Hemlock-white/Babot_revisioned_Mechatronics_TermProject/docs/develope_log.md

# BaBot development log

This log records the development sequence supported by the available files and conversation. Exact dates for the early conversion steps were not recorded. The new Git commits reconstruct milestones from KiCad's saved snapshots and the present files; their timestamps are **repository import dates**, not original design dates.

## Original project and local source archive

- **2025 source downloads:** Johan Link's [BABOT repository](https://github.com/JohanLink/BABOT) supplied `main.ino`, its README, and its CC BY-NC 4.0 license. Original Base and Plate PCBWay Gerbers/BOMs, the combined mechanical STL, a schematic PDF, and saved reference pages were downloaded separately. They are preserved in [`original/`](../original/) without editing their content. The PCBWay download names indicate 2025-05-26 for the Plate and 2025-05-27 for the Base; these are file labels, not verified manufacturing dates.
- **Early THT reconstruction; date not recorded:** Editable KiCad Base and Plate layouts were reconstructed from the original manufacturing Gerbers, flying-probe data, BOMs, and schematic information. The first Base version used an Arduino Micro module, through-hole parts, and the older digital-pot arrangement. The earliest surviving KiCad local-history snapshot is represented by the repository's initial THT commit; the superseded Base files remain in [`history/PCB/initial_THT_Base/`](../history/PCB/initial_THT_Base/).
- **Module and component revision; date not recorded:** The Base multiplexer IC was changed to a CD74HC4067 breakout module. A saved intermediate Base revision is captured as its own Git commit. The digital-pot module was then replaced by a Bourns 3296W 100 kΩ, 25-turn trimmer. The Plate design uses through-hole IR parts, a 2×10 header, and an FQP30N06L switch with a 220 Ω gate resistor. These circuit choices still need physical validation.
- **Routing attempts; date not recorded:** A two-layer Base layout was attempted, but its last recorded DRC had six signal and one GND connection open. The draft and trial files are archived in [`history/PCB/`](../history/PCB/). A separate four-layer Base was completed and routed; its last KiCad DRC reported zero violations and zero unconnected items.
- **2026-10-10 — Base fabrication and purchase data:** Four-layer Base Gerbers and drill files were exported and packaged as [`PCB/fabrication/BaBot_Base_THT_4layer_Gerbers.zip`](../PCB/fabrication/BaBot_Base_THT_4layer_Gerbers.zip). Both BOMs were grouped by purchasable part and given one-board/five-board quantities, stock fields, checkboxes, and supplier links. The Base power path uses a provisional 2 A assumption and an ordering recommendation of 1 oz inner copper; the actual servo loading has not been measured.
- **2026-10-11 — Repository organization:** Original downloads were separated from working files, early KiCad milestones were committed in sequence, and superseded Base work was moved to `history/`. `software/main.ino` is currently unchanged from the available upstream copy; there is no separately modified firmware yet. Hardware and system behavior have not been bench-tested.

## Routed Plate import and fabrication review

- **2026-10-13 — Gerbers supplied:** The owner placed the newer two-layer `BaBot_Plate_v2THT` package at [`PCB/fabrication/plate_THT_2layers_Gerbers.zip`](../PCB/fabrication/plate_THT_2layers_Gerbers.zip), with unpacked files in [`PCB/fabrication/plate/`](../PCB/fabrication/plate/). This is distinct from the original SMD Plate archive.
- **2026-10-13 — Export issue identified:** JLCPCB reported missing top and bottom solder masks. Both named mask files have no pad-opening graphics, and the package has no drill files. The Gerber job lists two copper layers, 1.6 mm thickness, and a 100.0456 × 101.5921 mm board. See the [detailed review and correction steps](../PCB/fabrication/plate/REVIEW_NOTES.md). The ZIP is **not fabrication-ready**.
- **Editable source still pending:** The routed `BaBot_Plate_v2THT.kicad_pcb` and project folder have not been located in this workspace. The Plate KiCad file currently under `PCB/KiCad/` is the older unrouted copy. A corrected Gerber/drill package, DRC, Base–Plate cable check, mechanical fit check, and prototype optical/electrical tests remain pending.
- **2026-10-13 — Circuit teaching:** Separate original and current THT circuit guides were written, then turned into offline HTML lessons with electrical schematics, power maps, a two-scan timing graph, and interactive sensor/mux/load examples. Software teaching remains deferred.
- **2026-10-13 — Software teaching:** A root-level, offline [BaBot navigator](../BaBot_導覽.html) was built from the unchanged `software/main.ino`. It embeds all 565 source lines, maps five verified architecture paths to code, and offers five theory modules with locally graded exercises. The builders and reviewed lesson data remain in `docs/`.

## Teaching documents

[`hardware_explained.md`](hardware_explained.md) remains intentionally blank. The electronics/circuit teaching has separate illustrated HTML lessons for the [original design](electronics_original.html) and [current THT/module design](electronics_tht.html), generated from their Markdown guides by [`build_electronics_html.py`](build_electronics_html.py). Software teaching is the root-level [architecture navigator](../BaBot_導覽.html), generated by [`build_software_navigator.py`](build_software_navigator.py) from a reviewed map of the upstream sketch. Previous Base/Plate circuit-learning drafts remain in [`history/notes/`](../history/notes/).
