Hemlock-white/Babot_revisioned_Mechatronics_TermProject/hardware/set up pics/Screenshot 2026-10-27 174410.png

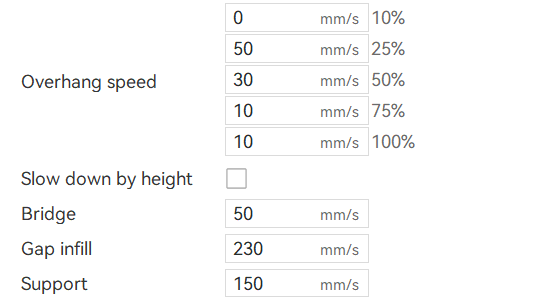
hardware/set up pics/Screenshot 2026-10-27 174410.png
