Hemlock-white/Babot_revisioned_Mechatronics_TermProject/PCB/KiCad/BaBot_Base_THT_4067_Module_BOM.csv

Have full 5-board qty? | References | Component / value | Qty per board | Qty for 5 boards | Qty on hand | Footprint / use | Side | Purpose / notes | Supplier Link
 | U4 | Arduino Micro A000053 | 1 | 5 |  | Arduino_Micro_A000053 | F | Preassembled ATmega32U4 module; USB logic supply and programming | https://shopee.tw/search?keyword=Arduino%20Micro%20A000053%20ATmega32U4%20original%20module
 | RV1 | Bourns 3296W-1-104LF 100k 25-turn | 1 | 5 |  | Potentiometer_THT:Potentiometer_Bourns_3296W_Vertical | F | Adjustable sensor-load resistor; pad 1 POT_H, wiper 2 and end 3 GND. Set about 10 kΩ from pad 1 to ground before power-up. | https://www.lcsc.com/product-detail/C48084.html
V | U1 | CD74HC4067 16-channel module | 1 | 5 |  | BaBot_THT:CD74HC4067_Module | F | THT breakout module containing CD74HC4067; connector positions mapped to standard IC pin numbers for schematic consistency | https://shopee.tw/search?keyword=CD74HC4067%2016%20channel%20multiplexer%20module
2 1*10 | U3 | 20-way header to Plate | 1 | 5 |  | Header20 | F | 2x10 2.54 mm male header to Plate; mate pin 1 to pin 1. | https://www.lcsc.com/product-detail/C54803349.html
V | H1,H2,H3 | Servo signal/+5V/GND | 3 | 15 |  | Position-specific THT footprints; see PCB refs | B | Three 3-pin servo headers; +5V_MOTORS, GND, signal. | https://s.taobao.com/search?q=PZ254V-11-03P%202.54mm%201x3%20vertical%20male%20pin%20header
 | R1,R7 | 10k | 2 | 10 |  | Axial_R_10.16 | B | 10 kΩ 0.25 W axial resistors; 10.16 mm lead spacing. | https://www.lcsc.com/product-detail/C2903232.html
 | R10,R18 | 500 | 2 | 10 |  | Axial_R_10.16 | B | 500 Ω 0.25 W axial resistors; R18 is in sensor-trimmer path. | https://www.lcsc.com/product-detail/C1370878.html
[] | C1 | 220nF leaded ceramic | 1 | 5 |  | Ceramic_5mm | B | 220 nF radial ceramic capacitor; 5 mm lead spacing. | https://shopee.tw/search?keyword=220nF%200.22uF%20ceramic%20disc%20capacitor%20radial%205mm%20pitch
 | C5 | 10uF 16V | 1 | 5 |  | Electrolytic_5mm | F | 10 µF 16 V leaded electrolytic on servo rail; check polarity and 2 mm lead pitch. | https://www.lcsc.com/product-detail/C442560.html
 | SW1 | Momentary NO | 1 | 5 |  | Pushbutton_6mm | F | Original active-high mode button; standard THT switch | https://shopee.tw/search
 | U15 | Red LED 3mm | 1 | 5 |  | LED_3mm | F | Original LED function; KiCad pin 1 cathode, pin 2 anode | https://shopee.tw/search?keyword=3mm%20red%20LED%20through%20hole%202%20lead
 | J1 | 5V servo power input | 1 | 5 |  | Power_Terminal | F | External regulated 5 V servo supply; separate from Micro USB logic supply | https://www.lcsc.com/product-detail/C5183929.html
V | ASSEMBLY-SOCKETS | 2.54 mm 1x40 female socket strip; 8.5 mm insulation height | 2 | 10 |  | Off-board stock cut into socket strips | F | Two 40-position strips supply 2x17 sockets for Arduino Micro plus 1x16 and 1x8 for mux module; verify module underside clearance and cutting waste. | https://www.lcsc.com/product-detail/C2977610.html
V | ASSEMBLY-PINS | 2.54 mm 1x40 male breakaway header | 2 | 10 |  | Off-board stock for module pins | F | Conditional: two strips supply 2x17 Arduino pins plus 1x16 and 1x8 mux pins if module headers are not pre-soldered; buy zero if both modules already have pins. | https://www.lcsc.com/product-detail/C2337.html
 | BASE-PLATE-CABLE | 20-conductor 2x10 double-ended IDC ribbon cable, 200 mm | 1 | 5 |  | Off-board interconnect | — | One straight-through cable per assembled Base+Plate pair. Verify female ends, 2.54 mm pitch, pin-1 orientation and suitable length. Counted only in Base BOM. | https://www.lcsc.com/product-detail/C7465815.html
