Hemlock-white/Babot_revisioned_Mechatronics_TermProject/PCB/KiCad/BaBot_Plate_THT_BOM.csv

Have full 5-board qty? | References | Component / value | Qty per board | Qty for 5 boards | Qty on hand | Footprint / use | Side | Purpose / notes | Supplier Link
 | IR1-IR21 | IR204/H60 | 21 | 105 |  | Position-specific THT footprints; see PCB refs | F | 21 infrared emitters; check anode/cathode orientation and optical match. | https://www.lcsc.com/product-detail/C60099.html
[] | Q1-Q16 | 1540031NC6090 | 16 | 80 |  | Position-specific THT footprints; see PCB refs | F | 16 infrared phototransistors; check polarity and package fit. | https://shopee.tw/search?keyword=Wurth%20Elektronik%201540031NC6090%20940nm%20phototransistor
 | R1-R21 | 330 | 21 | 105 |  | Axial_R_10.16 | B | 330 Ω 0.25 W axial IR current-limiting resistors; 10.16 mm lead spacing. | https://www.lcsc.com/product-detail/C2894590.html
 | U1 | 20-way header to Base | 1 | 5 |  | Header20 | B | 2x10 2.54 mm male header to Base, mounted on underside; pin 1 to pin 1. | https://www.lcsc.com/product-detail/C54803349.html
[] | Q17 | FQP30N06L | 1 | 5 |  | TO220_GDS | B | Logic-level THT MOSFET; G-D-S remapped from original G-S-D | https://www.lcsc.com/product-detail/C243087.html
 | R22 | 10k | 1 | 5 |  | Axial_R_10.16 | B | Gate pulldown, retained downstream of added gate resistor | https://www.lcsc.com/product-detail/C2903232.html
 | R23 | 220 | 1 | 5 |  | Axial_R_10.16 | B | Added MCU gate-current limiting resistor | https://www.lcsc.com/product-detail/C3537012.html
