Hemlock-white/Babot_revisioned_Mechatronics_TermProject/original/pcbway/plate/BOM_Plate_Plate_pcb_2025-05-26_PCBWay Community.csv

No. | Quantity | Comment | Designator | Footprint | Value | Manufacturer Part | Manufacturer | Supplier Part | Supplier
1 | 21 | IR204/H60 | IR1,IR2,IR3,IR4,IR5,IR6,IR7,IR8,IR9,IR10,IR11,IR12,IR13,IR14,IR15,IR16,IR17,IR18,IR19,IR20,IR21 | LED-TH_BD3.0-P2.54-FD |  | IR204/H60 | EVERLIGHT(亿光) | C60099 | LCSC
2 | 16 | 1540031NC6090 | Q1,Q2,Q3,Q4,Q5,Q6,Q7,Q8,Q9,Q10,Q11,Q12,Q13,Q14,Q15,Q16 | SENSOR-TH_TEFT4300 |  | 1540031NC6090 | Wurth Elektronik | 1540031NC6090
3 | 1 | AO3400A | Q17 | SOT-23-3_L3.0-W1.6-P1.90-LS2.8-BR |  | AO3400A | ElecSuper(静芯微) | C5224194 | LCSC
4 | 21 | 330Ω | R1,R2,R3,R4,R5,R6,R7,R8,R9,R10,R11,R12,R13,R14,R15,R16,R17,R18,R19,R20,R21 | R0805 | 330Ω | CR0805J80331G | LIZ(丽智电子) | C101994 | LCSC
5 | 1 | 10kΩ | R22 | R0402 | 10kΩ | SCR0402J10K | VO(翔胜) | C3017497 | LCSC
6 | 1 | 05A20L20P | U1 | FPC-SMD_20P-P0.50_L5.9-W14.4 |  | 05A20L20P | HanElectricity(瀚源) | C5362157 | LCSC
7 | 1 | FPC FLEX CABLE 100MM, 20P, Reverse Direction, 0.5mm
