Hemlock-white/Babot_revisioned_Mechatronics_TermProject/history/PCB/initial_THT_Base/BaBot_Base_THT_connections.csv

Reference | Pin | Net
U4 | 1 | MOSI
U4 | 3 | U2_DIN
U4 | 4 | U2_SCLK
U4 | 5 | RST
U4 | 6 | GND
U4 | 7 | SDA
U4 | 8 | SCL
U4 | 9 | U2_CS
U4 | 10 | U1_S0
U4 | 11 | U1_S2
U4 | 12 | IR_LED_CONTROL
U4 | 13 | LED_CONTROL
U4 | 14 | SERVOC
U4 | 15 | SERVOB
U4 | 16 | SERVOA
U4 | 17 | U1_S3
U4 | 18 | SCK
U4 | 19 | MISO
U4 | 21 | GND
U4 | 22 | RST
U4 | 23 | +5V_LOGIC
U4 | 30 | BUTTON
U4 | 31 | U1_SIG
U4 | 34 | U1_S1
U2 | 3 | U2_CS
U2 | 4 | U2_SCLK
U2 | 6 | U2_DIN
U2 | 7 | +5V_LOGIC
U2 | 8 | GND
U2 | 9 | GND
U2 | 10 | +5V_LOGIC
U1 | 1 | U1_SIG
U1 | 2 | PT07
U1 | 3 | PT06
U1 | 4 | PT05
U1 | 5 | PT04
U1 | 6 | PT03
U1 | 7 | PT02
U1 | 8 | PT01
U1 | 9 | PT00
U1 | 10 | U1_S0
U1 | 11 | U1_S1
U1 | 12 | GND
U1 | 13 | U1_S3
U1 | 14 | U1_S2
U1 | 15 | U1_EN
U1 | 16 | PT15
U1 | 17 | PT14
U1 | 18 | PT13
U1 | 19 | PT12
U1 | 20 | PT11
U1 | 21 | PT10
U1 | 22 | PT09
U1 | 23 | PT08
U1 | 24 | +5V_LOGIC
U3 | 1 | PT00
U3 | 2 | PT01
U3 | 3 | PT02
U3 | 4 | PT03
U3 | 5 | PT04
U3 | 6 | PT05
U3 | 7 | PT06
U3 | 8 | PT07
U3 | 9 | PT08
U3 | 10 | PT09
U3 | 11 | PT10
U3 | 12 | PT11
U3 | 13 | PT12
U3 | 14 | PT13
U3 | 15 | PT14
U3 | 16 | PT15
U3 | 17 | IR_LED_CONTROL
U3 | 18 | +5V_SERVO
U3 | 19 | +5V_LOGIC
U3 | 20 | GND
H1 | 1 | SERVOA
H1 | 2 | +5V_SERVO
H1 | 3 | GND
H2 | 1 | SERVOB
H2 | 2 | +5V_SERVO
H2 | 3 | GND
H3 | 1 | SERVOC
H3 | 2 | +5V_SERVO
H3 | 3 | GND
R1 | 1 | GND
R1 | 2 | U1_EN
R7 | 1 | GND
R7 | 2 | BUTTON
R10 | 1 | LED_K
R10 | 2 | GND
R18 | 1 | U1_SIG
R18 | 2 | POT_H
C1 | 1 | +5V_LOGIC
C1 | 2 | GND
C5 | 1 | +5V_SERVO
C5 | 2 | GND
SW1 | 1 | +5V_LOGIC
SW1 | 2 | BUTTON
U15 | 1 | LED_K
U15 | 2 | LED_CONTROL
J1 | 1 | +5V_SERVO
J1 | 2 | GND
J2 | 1 | POT_H
J2 | 2 | GND
J2 | 3 | GND
