Hemlock-white/Babot_revisioned_Mechatronics_TermProject/original/pcbway/base/BOM_Base_Base_pcb_2025-05-27_PCBWay Community.xlsx

No. | Quantity | Comment | Designator | Footprint | Value | Manufacturer Part | Manufacturer | Supplier Part | Supplier
1 | 1 | 220nF | C1 | C0603 | 220nF | CS1608Y5V224Z160NRB | SAMWHA(三和) | C5189835 | LCSC
2 | 3 | 1uF | C2,C3,C4 | C0603 | 1uF | CS1608X5R105K250NRB | SAMWHA(三和) | C2918486 | LCSC
3 | 1 | 10uF | C5 | C1206 | 10uF | CS3216X7R106K350NRI | SAMWHA(三和) | C920965 | LCSC
4 | 5 | PZ254V-11-03P | H1,H2,H3,H4,H5 | HDR-TH_3P-P2.54-V-M |  | PZ254V-11-03P | XFCN(兴飞) | C2937625 | LCSC
5 | 3 | 10kΩ | R1,R6,R7 | R0402 | 10kΩ | SCR0402J10K | VO(翔胜) | C3017497 | LCSC
6 | 3 | 500Ω | R10,R11,R18 | R0805 | 500Ω | ARG05FTC5000 | Viking(光颉) | C2828857 | LCSC
7 | 4 | 5.1kΩ | R14,R15,R16,R17 | R1206 | 5.1kΩ | FRC1206J512 TS | FOJAN(富捷) | C2907509 | LCSC
8 | 1 | TSC015A03526A | SW1 | SW-SMD_4P-L4.5-W4.5-P3.00-LS6.8 |  | TSC015A03526A | BZCN(博众电气) | C2888900 | LCSC
9 | 1 | CD74HC4067SM96 | U1 | SSOP-24_L8.1-W5.3-P0.65-LS7.8-BL |  | CD74HC4067SM96 | TI(德州仪器) | C98457 | LCSC
10 | 1 | TPL0501-100DCNR | U2 | SOT-23-8_L3.0-W1.7-P0.65-LS2.8-BL |  | TPL0501-100DCNR | TI(德州仪器) | C131323 | LCSC
11 | 1 | 05A20L20P | U3 | FPC-SMD_20P-P0.50_L5.9-W14.4 |  | 05A20L20P | HanElectricity(瀚源) | C5362157 | LCSC
12 | 1 | ATMEGA32U4-AU | U4 | QFP-44_L10.0-W10.0-P0.80-LS13.2-BL |  | ATMEGA32U4-AU | MICROCHIP(美国微芯) | C44854 | LCSC
13 | 2 | 22pF | U8,U10 | C1206 | 22pF | FCC1206N220J102DT | FOJAN(富捷) | C5137630 | LCSC
14 | 1 | 16MHz | U9 | HC-49S_L11.0-W4.7-P4.88 | 16MHz | HY16M49SOB2T02 | Huiyuan crystal(惠源晶工) | C5265724 | LCSC
15 | 2 | 918-418K2023S40050 | U12,U19 | USB-C-SMD_918-418K2023S40023 |  | 918-418K2023S40050 | 精拓金 | C19189946 | LCSC
16 | 2 | YLED1206R | U14,U15 | LED1206-FD |  | YLED1206R | YONGYUTAI(永裕泰) | C28310439 | LCSC
17 | 2 | SS24AF | U20,U21 | SMAF_L3.5-W2.6-LS4.6-RD |  | SS24AF | ZHIDE(志得) | C5161869 | LCSC
18 | 5 | Solder Bridge | U22,U23,U24,U25,U26 | solder bridge 2p bridged2
