Hemlock-white/Babot_revisioned_Mechatronics_TermProject/hardware/mechanical/plateNsurfaceHolder.stl

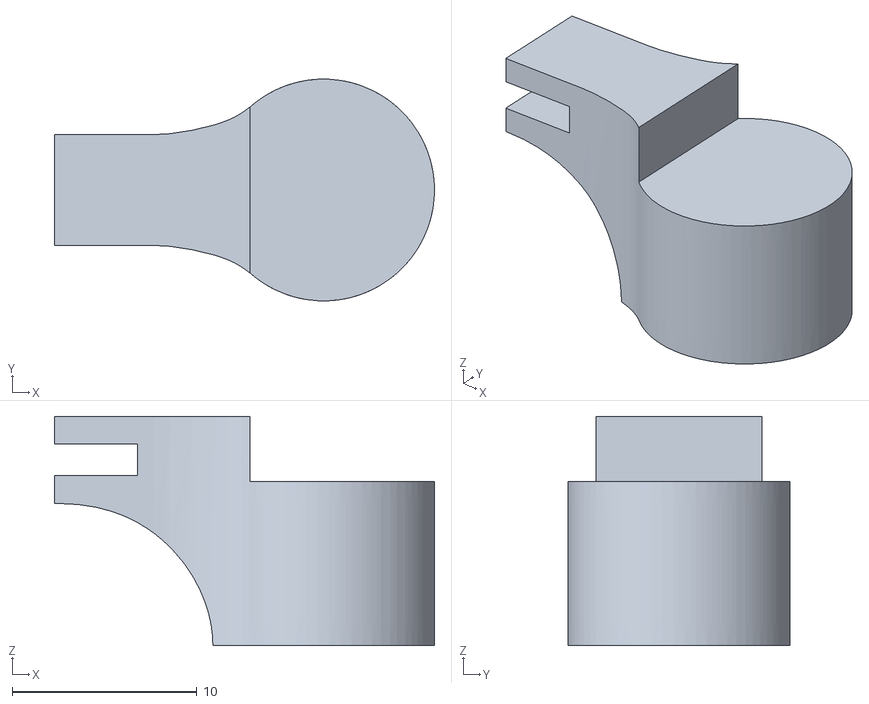
[picture p6: CAD file, 2026-10-29]
hardware/mechanical/plateNsurfaceHolder.stl
20.6 x 12.0 x 12.4
