Hemlock-white/Babot_revisioned_Mechatronics_TermProject/original/mechanical/all_hYIYvbA6Sb.stl

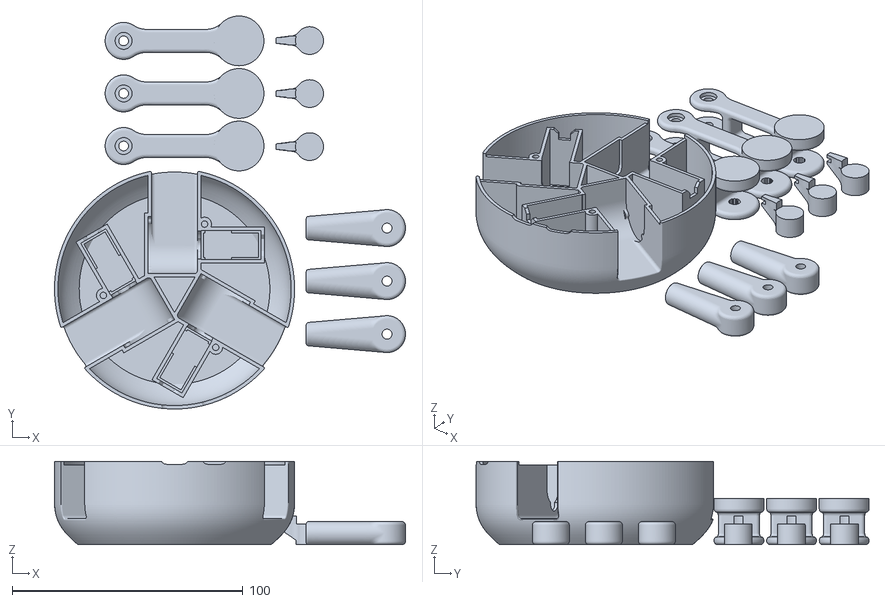
[picture p7: CAD file, 2026-10-10]
original/mechanical/all_hYIYvbA6Sb.stl
152.0 x 170.2 x 36.1
