Hemlock-white/Babot_revisioned_Mechatronics_TermProject/hardware/mechanical/spacer.stl

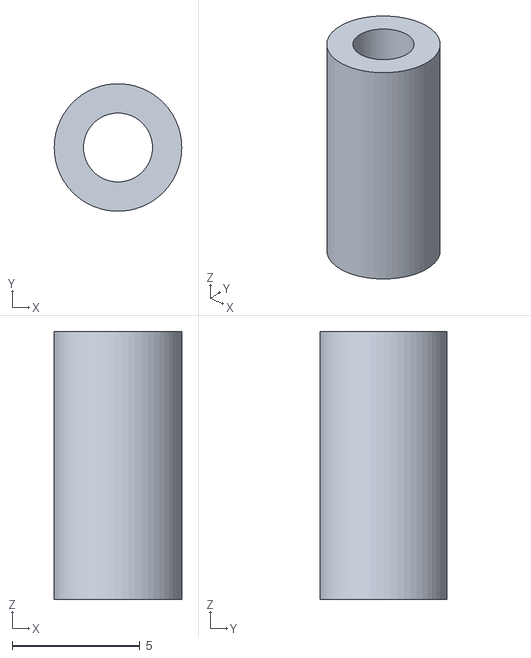
[picture p8: CAD file, 2026-10-29]
hardware/mechanical/spacer.stl
5.00 x 4.99 x 10.5
