Hemlock-white/Babot_revisioned_Mechatronics_TermProject/hardware/mechanical/linkNsocket.stl

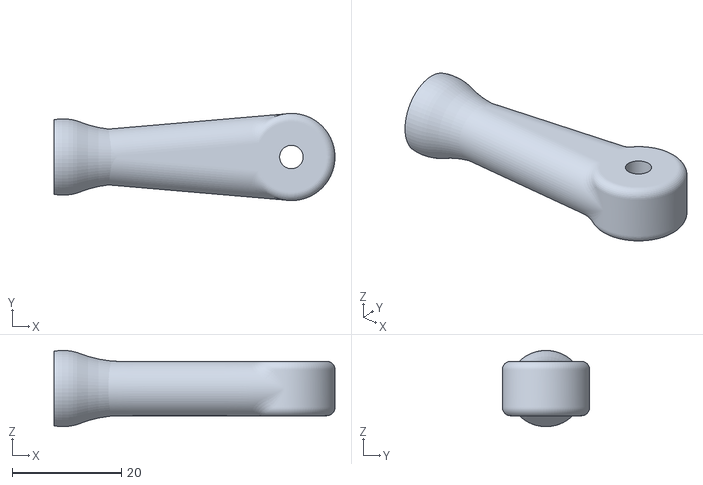
[picture p9: CAD file, 2026-10-29]
hardware/mechanical/linkNsocket.stl
51.6 x 16.0 x 14.0
