Hemlock-white/Babot_revisioned_Mechatronics_TermProject/hardware/mechanical/MotorLink.stl

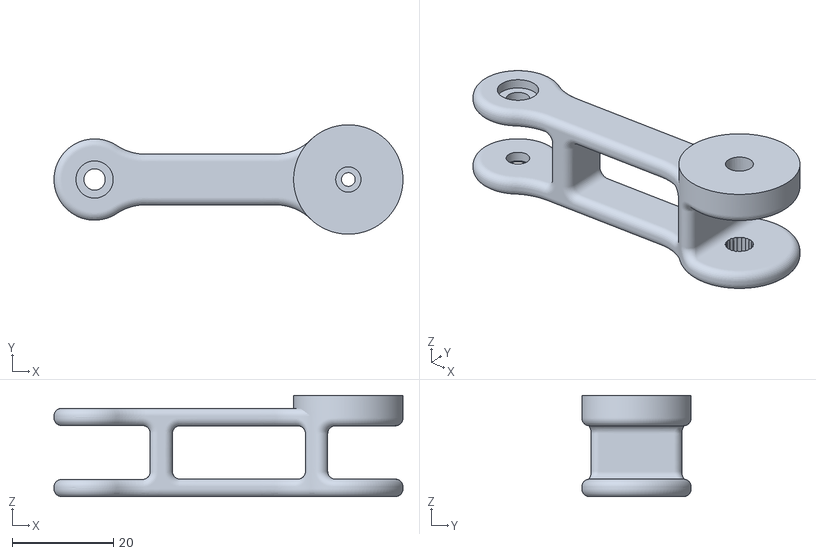
[picture p10: CAD file, 2026-10-29]
hardware/mechanical/MotorLink.stl
68.8 x 21.5 x 20.0
