Hemlock-white/Babot_revisioned_Mechatronics_TermProject/hardware/mechanical/base.stl

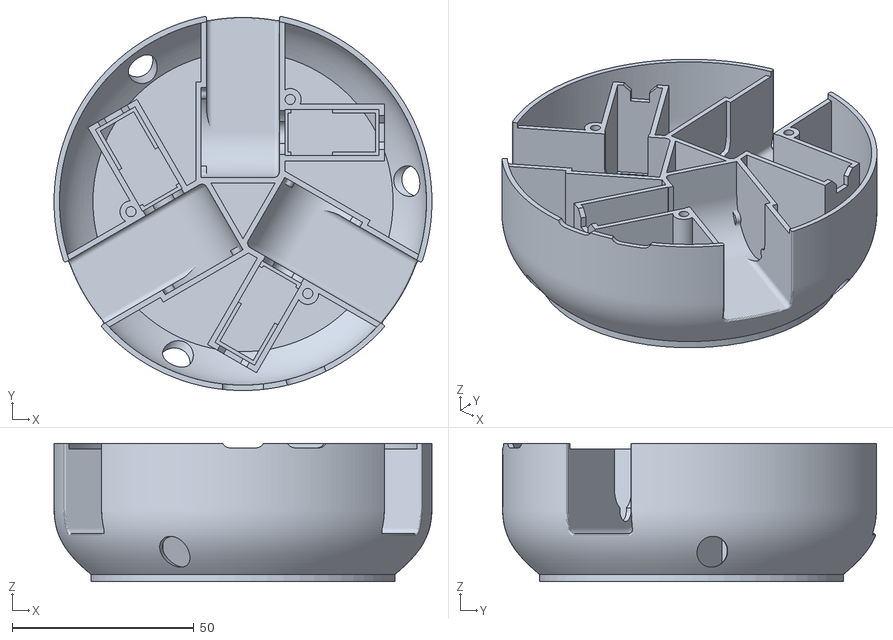
[picture p11: CAD file, 2026-10-29]
hardware/mechanical/base.stl
104.0 x 102.9 x 38.1
