Hemlock-white/Babot_revisioned_Mechatronics_TermProject/original/web_captures/BaBot_ Build Your Own Ball-Balancing Robot - Hackster.io.html

×

### Embed the widget on your own site

Add the following snippet to your HTML:<iframe frameborder='0' height='385' scrolling='no' src='https://www.hackster.io/johanlinkemail/babot-build-your-own-ball-balancing-robot-2c1a5a/embed' width='350'></iframe>

BaBot is a compact, open-source robot that balances a ball in real-time using an array of infrared (IR) sensors. (https://www.hackster.io/johanlinkemail/babot-build-your-own-ball-balancing-robot-2c1a5a)

Read up about this project on Hackster.io

#### BaBot: Build Your Own Ball-Balancing Robot (https://www.hackster.io/johanlinkemail/babot-build-your-own-ball-balancing-robot-2c1a5a)

Johan Link (https://www.hackster.io/johanlinkemail)

13 2,265

- Overview (https://www.hackster.io/johanlinkemail/babot-build-your-own-ball-balancing-robot-2c1a5a#overview)
- Things (https://www.hackster.io/johanlinkemail/babot-build-your-own-ball-balancing-robot-2c1a5a#things)
- Story (https://www.hackster.io/johanlinkemail/babot-build-your-own-ball-balancing-robot-2c1a5a#story)
  - Step 1: Order Your PCBs (https://www.hackster.io/johanlinkemail/babot-build-your-own-ball-balancing-robot-2c1a5a)
  - Step 2: Print the 3D printed parts (https://www.hackster.io/johanlinkemail/babot-build-your-own-ball-balancing-robot-2c1a5a)
  - Step 3: Assemble the Arms and Servos (https://www.hackster.io/johanlinkemail/babot-build-your-own-ball-balancing-robot-2c1a5a)
  - Step 4: Assemble the Base (https://www.hackster.io/johanlinkemail/babot-build-your-own-ball-balancing-robot-2c1a5a)
  - Step 5: Mount the Top Plate (https://www.hackster.io/johanlinkemail/babot-build-your-own-ball-balancing-robot-2c1a5a)
  - Step 6: Upload the Code (https://www.hackster.io/johanlinkemail/babot-build-your-own-ball-balancing-robot-2c1a5a)
  - How It Works (https://www.hackster.io/johanlinkemail/babot-build-your-own-ball-balancing-robot-2c1a5a)
  - Where to Get Your BaBot (https://www.hackster.io/johanlinkemail/babot-build-your-own-ball-balancing-robot-2c1a5a)
- Custom parts and enclosures (https://www.hackster.io/johanlinkemail/babot-build-your-own-ball-balancing-robot-2c1a5a#cad)
- Schematics (https://www.hackster.io/johanlinkemail/babot-build-your-own-ball-balancing-robot-2c1a5a#schematics)
- Code (https://www.hackster.io/johanlinkemail/babot-build-your-own-ball-balancing-robot-2c1a5a#code)
- Credits (https://www.hackster.io/johanlinkemail/babot-build-your-own-ball-balancing-robot-2c1a5a#team)
- Comments(0) (https://www.hackster.io/johanlinkemail/babot-build-your-own-ball-balancing-robot-2c1a5a#comments)

13

Johan Link

Johan Link (https://www.hackster.io/johanlinkemail)

Published May 5, 2025 © CC BY-NC (http://creativecommons.org/licenses/by-nc/4.0)

# BaBot: Build Your Own Ball-Balancing Robot

BaBot is a compact, open-source robot that balances a ball in real-time using an array of infrared (IR) sensors.

Intermediate (https://www.hackster.io/projects?difficulty=intermediate)Full instructions provided2 hours2,265

(https://www.avnet.com/americas/products/new-product-introductions/npi/nxp-mcx-l-series-microcontrollers/)

Ad (http://help.hackster.io/knowledgebase/what-are-these-ads)

## (https://www.hackster.io/johanlinkemail/babot-build-your-own-ball-balancing-robot-2c1a5a#things)Things used in this project

Hardware components
SG90 Micro-servo motor

SG90 Micro-servo motor
× | 1 | (https://www.hackster.io/products/buy/37329?s=BAhJIhM1Mjc3OTIsUHJvamVjdAY6BkVG%0A)
PCBWay Custom PCB

PCBWay Custom PCB (https://www.hackster.io/pcbway/products/custom-pcb?ref=project-2c1a5a)
× | 1 | (https://www.hackster.io/products/buy/34621?s=BAhJIhM1Mjc3OTIsUHJvamVjdAY6BkVG%0A)
Software apps and online services
Arduino IDE

Arduino IDE (https://www.hackster.io/arduino/products/arduino-ide?ref=project-2c1a5a)
| | (https://www.arduino.cc/en/main/software)
Hand tools and fabrication machines
3D Printer (generic)

3D Printer (generic)
Soldering iron (generic)

Soldering iron (generic)

## (https://www.hackster.io/johanlinkemail/babot-build-your-own-ball-balancing-robot-2c1a5a#story)Story

BaBot (http://ba-bot.com/)began as a high school project in 2018, initially using a computer and overhead camera for ball tracking. After several iterations, including a Raspberry Pi version with a camera beneath a transparent plate, I developed a more efficient design. The current version utilizes IR sensors and an ATmega32U4 microcontroller, resulting in a more compact, affordable, and user-friendly robot.

### Step 1: Order Your PCBs

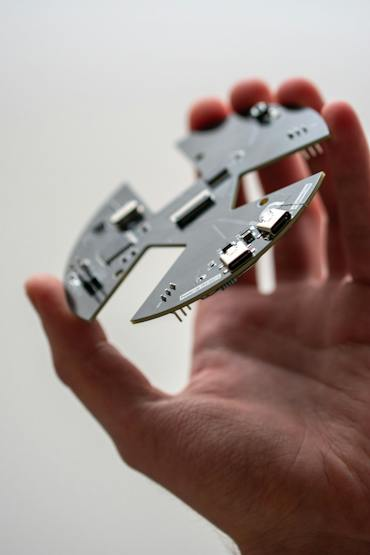
[picture p12: original/web_captures/BaBot_ Build Your Own Ball-Balancing Robot - Hackster.io_files/dsc_0017_9IIX3npD7x.jpg]


To make things easier and more reliable, I highly recommend ordering the PCBs pre-assembled, especially since they contain a number of SMD components.

👉 You can order the assembled PCBs directly from PCBWay. (https://www.pcbway.com/project/shareproject/BaBot_Build_Your_Own_Ball_Balancing_Robot_7efa0601.html)

Alternatively, if you'd like the most seamless experience, you can purchase the complete BaBot kit (with all components included) from ba-bot.com. That way, you skip the hassle of sourcing individual parts and can focus entirely on building and enjoying your robot.

Step 2: Print the 3D printed parts

### Step 2: Print the 3D printed parts



1 / 2

All the structural parts of BaBot can be 3D printed. Make sure to use a printer that offers high precision, particularly for the parts that interface directly with the servos. All the parts can be found on Thingiverse. (https://www.thingiverse.com/thing:7021268/files)

### Step 3: Assemble the Arms and Servos

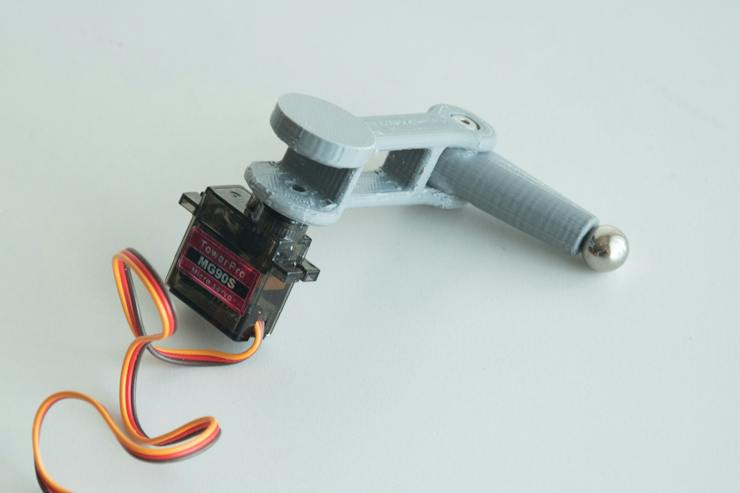
[picture p13: original/web_captures/BaBot_ Build Your Own Ball-Balancing Robot - Hackster.io_files/dsc_0015_lxuqYw8kLg.jpg]


Once your 3D printed parts are ready, start by assembling the three arms and attaching them to the MG90S servos.

### Step 4: Assemble the Base

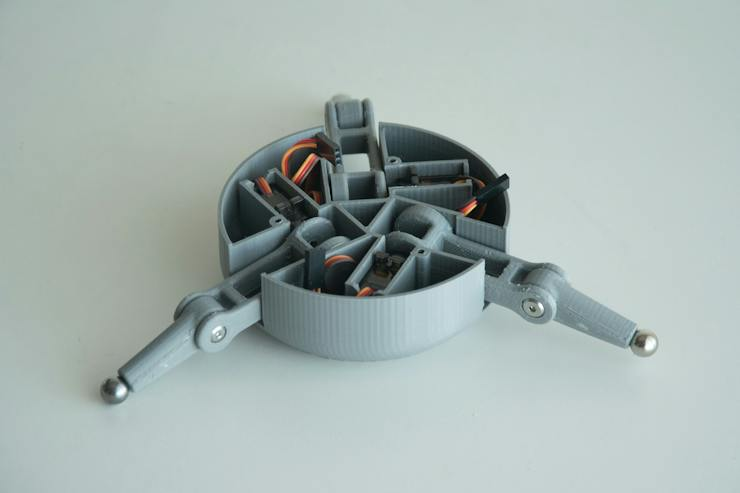
[picture p14: original/web_captures/BaBot_ Build Your Own Ball-Balancing Robot - Hackster.io_files/dsc_0017_EyxJsKmgT3.jpg]


1 / 2

Next, mount the servo arms onto the base. This structure serves as the foundation of BaBot, supporting the electronics and handling the balancing mechanism.

### Step 5: Mount the Top Plate

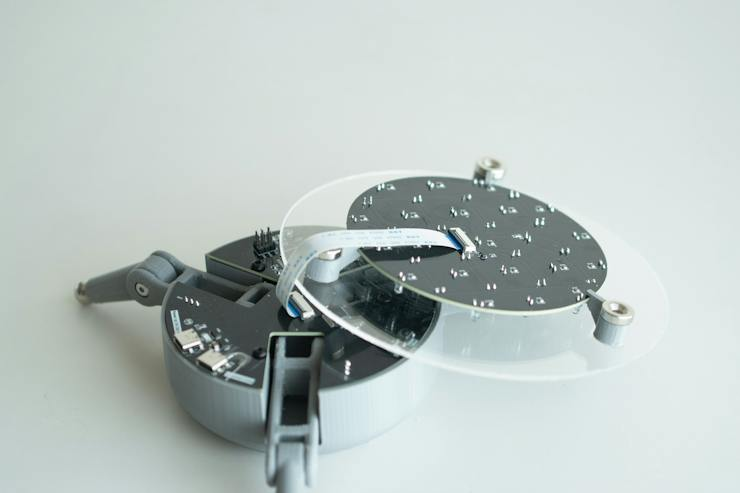
[picture p15: original/web_captures/BaBot_ Build Your Own Ball-Balancing Robot - Hackster.io_files/dsc_0021_oHtT44iWZO.jpg]


Now attach the top acrylic plate to the second PCB.

### Step 6: Upload the Code

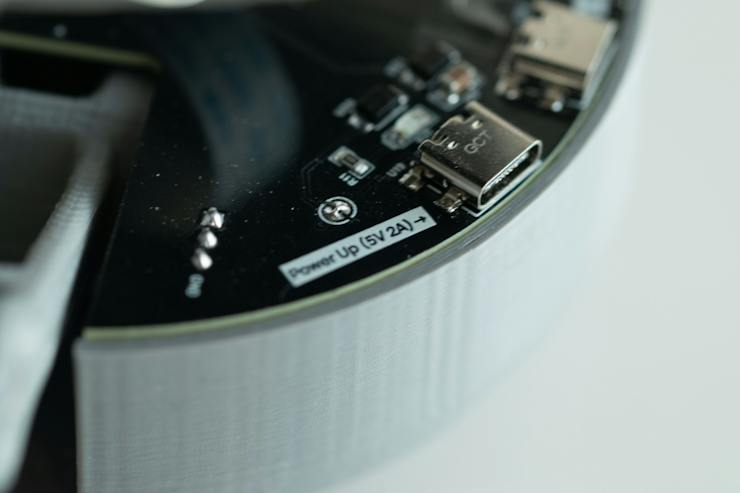
[picture p16: original/web_captures/BaBot_ Build Your Own Ball-Balancing Robot - Hackster.io_files/dsc_0023_2mr8bIN5SV.jpg]


Use the Arduino IDE to upload the firmware to the ATmega32U4 microcontroller on the PCB. The code is open-source and available on the GitHub page. The code is already commented to help you understand how it works, and more detailed explanations will be added to ba-bot.com once the project is fully finalized.

### How It Works ?

When you place a ball on BaBot's transparent plate, a sequence of events unfolds:

- Infrared Detection: Beneath the plate lies a secondary printed circuit board embedded with numerous infrared (IR) LEDs and IR phototransistors. These IR LEDs emit light upward, which reflects off the bottom of the ball and is captured by the phototransistors. This setup allows BaBot to accurately determine the ball's position on the plate in real-time.
- Infrared Detection: Beneath the plate lies a secondary printed circuit board embedded with numerous infrared (IR) LEDs and IR phototransistors. These IR LEDs emit light upward, which reflects off the bottom of the ball and is captured by the phototransistors. This setup allows BaBot to accurately determine the ball's position on the plate in real-time.
- Data Processing: The position data collected by the secondary PCB is transmitted to the main PCB, which houses an ATmega32U4 microcontroller, similar to the one found in the Arduino Leonardo. This microcontroller processes the data using a PID (Proportional-Integral-Derivative) algorithm. The PID algorithm calculates the difference between the ball's current position and the desired target position (typically the center of the plate).
- Data Processing: The position data collected by the secondary PCB is transmitted to the main PCB, which houses an ATmega32U4 microcontroller, similar to the one found in the Arduino Leonardo. This microcontroller processes the data using a PID (Proportional-Integral-Derivative) algorithm. The PID algorithm calculates the difference between the ball's current position and the desired target position (typically the center of the plate).
- Calculating Plate Tilt: To correct the ball's position, BaBot must tilt the plate appropriately. This involves solving inverse kinematics equations to determine the precise angles needed for each of the three servo motors to achieve the desired tilt.
- Calculating Plate Tilt: To correct the ball's position, BaBot must tilt the plate appropriately. This involves solving inverse kinematics equations to determine the precise angles needed for each of the three servo motors to achieve the desired tilt.
- Actuating Movement: The calculated angles are sent to the servo motors, each connected to articulated arms ending in metallic balls. These balls serve as joints and are magnetically attached to the underside of the plate, allowing smooth and responsive movement.
- Actuating Movement: The calculated angles are sent to the servo motors, each connected to articulated arms ending in metallic balls. These balls serve as joints and are magnetically attached to the underside of the plate, allowing smooth and responsive movement.
- Continuous Feedback Loop: After adjusting the plate's orientation, the system re-measures the ball's position, and the process repeats. This feedback loop operates approximately 30 times per second, ensuring the ball remains balanced on the plate.
- Continuous Feedback Loop: After adjusting the plate's orientation, the system re-measures the ball's position, and the process repeats. This feedback loop operates approximately 30 times per second, ensuring the ball remains balanced on the plate.

This seamless integration of sensors, control algorithms, and mechanical components enables BaBot t (https://www.ba-bot.com/)o perform real-time ball balancing, offering an engaging demonstration of robotics and control systems in action.

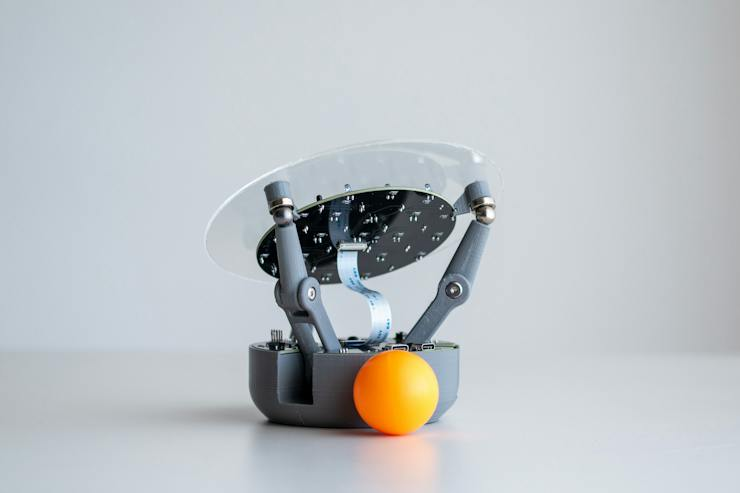
[picture p17: original/web_captures/BaBot_ Build Your Own Ball-Balancing Robot - Hackster.io_files/dsc_0029_jV5JceUJqE.jpg]


### Where to Get Your BaBot ?

BaBot (https://www.ba-bot.com/)o (https://www.ba-bot.com/)ffers a hands-on experience in building and understanding a real-time control system. Its open-source design encourages experimentation and learning, making it an excellent project for both beginners and experienced makers.

For those interested in exploring BaBot further or obtaining a kit, more information is available at ba-bot.com (https://www.ba-bot.com/)

Whether you're a teacher seeking an engaging classroom project, a student eager to delve into robotics, or simply someone who appreciates innovative gadgets, BaBot is designed to captivate and educate.

No prior experience is necessary, just a curious mind and the enthusiasm to build something remarkable.

Read more

## (https://www.hackster.io/johanlinkemail/babot-build-your-own-ball-balancing-robot-2c1a5a#cad)Custom parts and enclosures

### BaBot's 3D printed parts

(https://hacksterio.s3.amazonaws.com/uploads/attachments/1845230/all_hYIYvbA6Sb.stl)

## (https://www.hackster.io/johanlinkemail/babot-build-your-own-ball-balancing-robot-2c1a5a#schematics)Schematics

### BaBot's schematics

(https://hacksterio.s3.amazonaws.com/uploads/attachments/1845254/schematics_iNWgbALrz5.pdf)

## (https://www.hackster.io/johanlinkemail/babot-build-your-own-ball-balancing-robot-2c1a5a#code)Code

### BaBot's code

(https://github.com/JohanLink/BABOT)

### JohanLink (https://github.com/JohanLink) / BABOT (https://github.com/JohanLink/BABOT)

110 (https://github.com/JohanLink/BABOT/watchers) 13 (https://github.com/JohanLink/BABOT/forks)

The open-source ball-balancing robot you build, program, and bring to life. — Read More (https://github.com/JohanLink/BABOT#readme)

https://Ba-Bot.com

Latest commit to the master branch on 5-29-2026

Download as zip (https://github.com/JohanLink/BABOT/archive/main.zip)

## (https://www.hackster.io/johanlinkemail/babot-build-your-own-ball-balancing-robot-2c1a5a#team)Credits

Johan Link (https://www.hackster.io/johanlinkemail)

### Johan Link (https://www.hackster.io/johanlinkemail)

1 project • 2 followers

Follow Contact (https://www.hackster.io/users/sign_up)

## (https://www.hackster.io/johanlinkemail/babot-build-your-own-ball-balancing-robot-2c1a5a#comments)Comments

Please log in or sign up to comment.

Start the conversation!

(https://www.avnet.com/americas/products/new-product-introductions/npi/nxp-mcx-l-series-microcontrollers/)

Ad (http://help.hackster.io/knowledgebase/what-are-these-ads)

##### Related channels and tags

- PCBWay (https://www.hackster.io/pcbway)
- Robotics (https://www.hackster.io/robotics)
- Robotics (https://www.hackster.io/robotics)
- infrared (https://www.hackster.io/projects/tags/infrared)
- pcb (https://www.hackster.io/projects/tags/pcb)
- pid control (https://www.hackster.io/projects/tags/pid+control)
- robotics (https://www.hackster.io/projects/tags/robotics)

##### Related projects

Otto Robot || Arduino Robot || Simple Arduino Robot (https://www.hackster.io/Vishalsoniindia/otto-robot-arduino-robot-simple-arduino-robot-428bfb)

Otto Robot || Arduino Robot || Simple Arduino Robot (https://www.hackster.io/Vishalsoniindia/otto-robot-arduino-robot-simple-arduino-robot-428bfb)

Drawing Robot | Arduino Servo Robot | Rangoli Making Robot (https://www.hackster.io/RoboticsEveryDay/drawing-robot-arduino-servo-robot-rangoli-making-robot-7e3d60)

Drawing Robot | Arduino Servo Robot | Rangoli Making Robot (https://www.hackster.io/RoboticsEveryDay/drawing-robot-arduino-servo-robot-rangoli-making-robot-7e3d60)

Omni Wheel Robot – A Robot That Can Move In Any Direction (https://www.hackster.io/CiferTech/omni-wheel-robot-a-robot-that-can-move-in-any-direction-dced52)

Omni Wheel Robot – A Robot That Can Move In Any Direction (https://www.hackster.io/CiferTech/omni-wheel-robot-a-robot-that-can-move-in-any-direction-dced52)

Edge detection robot | Smart Robot | Arduino Robot (https://www.hackster.io/Techatronic/edge-detection-robot-smart-robot-arduino-robot-eecb33)

Edge detection robot | Smart Robot | Arduino Robot (https://www.hackster.io/Techatronic/edge-detection-robot-smart-robot-arduino-robot-eecb33)

DIY Industrial Pick & Place Robot | Hybrid Delta Robot (https://www.hackster.io/RoboticsEveryDay/diy-industrial-pick-place-robot-hybrid-delta-robot-a8840c)

DIY Industrial Pick & Place Robot | Hybrid Delta Robot (https://www.hackster.io/RoboticsEveryDay/diy-industrial-pick-place-robot-hybrid-delta-robot-a8840c)

View more related projects (https://www.hackster.io/johanlinkemail/babot-build-your-own-ball-balancing-robot-2c1a5a)

## Similar projects you might like

Step aside, an amazing six-wheel off-road robot coming through! Check out this Arduino-based wireless surveillance DIY RC robot. (https://www.hackster.io/jithinsanal1610/amazing-6wd-off-road-robot-arduino-rc-robot-44eb5c)

Amazing 6WD Off-Road Robot | Arduino RC Robot (https://www.hackster.io/jithinsanal1610/amazing-6wd-off-road-robot-arduino-rc-robot-44eb5c)

Jithin Sanal (https://www.hackster.io/jithinsanal1610)

10735K

WORK IN PROGRESS. Scriba is a printing robot which uses cameras to correct its trajectory and alignment. (https://www.hackster.io/robinb/scriba-robot-a-printing-robot-0048fa)

Scriba Robot - A Printing Robot (https://www.hackster.io/robinb/scriba-robot-a-printing-robot-0048fa)

RobinB (https://www.hackster.io/robinb)

2510K

An educational robot car that uses a mecanum wheel and is controlled with a PS3 controller! (https://www.hackster.io/earldanielph/mechamaven-the-educational-robot-explorer-4648c7)

MechaMaven: The Educational Robot Explorer! (https://www.hackster.io/earldanielph/mechamaven-the-educational-robot-explorer-4648c7)

Earl Daniel Villanueva (https://www.hackster.io/earldanielph)

3272

How to build a bluetooth enabled robot with Elegoo's comprehensive robot car kit. Tutorial includes construction and programming. (https://www.hackster.io/wsawan/elegoo-robot-car-building-a-bluetooth-enabled-robot-car-2c6ab1)

Elegoo Robot Car - Building a Bluetooth Enabled Robot Car (https://www.hackster.io/wsawan/elegoo-robot-car-building-a-bluetooth-enabled-robot-car-2c6ab1)

Waleed Sawan (https://www.hackster.io/wsawan)

245.4K

This is a robot that copies others' homework and writes it in your handwriting. Best in Online Classes during Pandemic. (https://www.hackster.io/RoboticsEveryDay/homework-copying-robot-handwriting-copying-robot-7fe216)

Homework Copying Robot | Handwriting Copying Robot (https://www.hackster.io/RoboticsEveryDay/homework-copying-robot-handwriting-copying-robot-7fe216)

Robotics EveryDay (https://www.hackster.io/RoboticsEveryDay)

81.6K

Hi everyone! In this project, I will show you an amazing eight-legged robot in the Octopod style! (https://www.hackster.io/mertarduino/3d-printed-theo-jansen-style-octopod-robot-arduino-based-52f8f8)

3D Printed Theo Jansen Style Octopod Robot (Arduino Based) (https://www.hackster.io/mertarduino/3d-printed-theo-jansen-style-octopod-robot-arduino-based-52f8f8)

Maker 101 (https://www.hackster.io/mertarduino)

111.6K

Fully autonomous line follower robot designed and built from scratch. (https://www.hackster.io/costelpetrea15/autonomous-line-follower-robot-5755e8)

Autonomous Line Follower Robot (https://www.hackster.io/costelpetrea15/autonomous-line-follower-robot-5755e8)

Costel Petrea (https://www.hackster.io/costelpetrea15)

21

Make a teleoperated rescue robot out of Lego Technic, Arduino boards, off-the-shelf DC and servo motors, and NRF communication modules. (https://www.hackster.io/tartrobotics/a-diy-remote-controlled-rescue-robot-with-arduino-and-lego-e21353)

A DIY Remote-Controlled Rescue Robot with Arduino and Lego (https://www.hackster.io/tartrobotics/a-diy-remote-controlled-rescue-robot-with-arduino-and-lego-e21353)

Tart Robotics (https://www.hackster.io/tartrobotics)

259.9K



1

2

3

Hey stranger! Sign up to access unlimited projects featuring Robotics and more – it's free.

Sign upNot now

13

### About Us

- Hackster Overview (https://www.hackster.io/about)
- Hackster for Business (https://www.hackster.io/business)
- Help Articles (https://help.hackster.io/)
- Brand Resources (https://www.hackster.io/branding)
- Sitemap (https://www.hackster.io/sitemap.html.html)

### Legal Thingies

- Terms of Service (https://www.hackster.io/terms)
- Contest Rules (https://www.hackster.io/contest-rules)
- Code of Conduct (https://www.hackster.io/conduct)
- Privacy Policy (https://www.hackster.io/privacy)
- Privacy Policy for California Residents (https://www.hackster.io/privacy/ccpa)
- Cookie Preferences

### Find Us On Social

- Facebook (https://www.facebook.com/hacksterio)
- Instagram (https://www.instagram.com/hacksterio)
- LinkedIn (https://www.linkedin.com/company/hacksterio)
- X (https://www.twitter.com/hacksterio)
- YouTube (https://www.youtube.com/hacksterio)

### Visit Our Avnet Family

- Avnet (https://www.avnet.com/)
- Premier Farnell (https://www.farnell.com/)
- element14 (https://www.element14.com/)
- Newark (https://www.newark.com/)

Hackster.io, an Avnet Community © 2026
