Hemlock-white/Babot_revisioned_Mechatronics_TermProject/original/web_captures/Manual – BaBot.html

Worldwide Free shipping

BaBot (https://ba-bot.com/)

(https://ba-bot.com/cart)

Documentation

# BaBot Manual

Thank you for being a BaBot owner. This manual will guide you step by step through the assembly process, from identifying each part to getting your robot up and running.

## Assembly Instructions

1. 01

### Assemble the Arms

  Each arm is made of 6 parts: 2 white plastic components, 1 metal ball, 2 screws, and 1 set screw. When fastening the screws, avoid overtightening. The joint should be secure while still allowing smooth rotation with minimal friction.
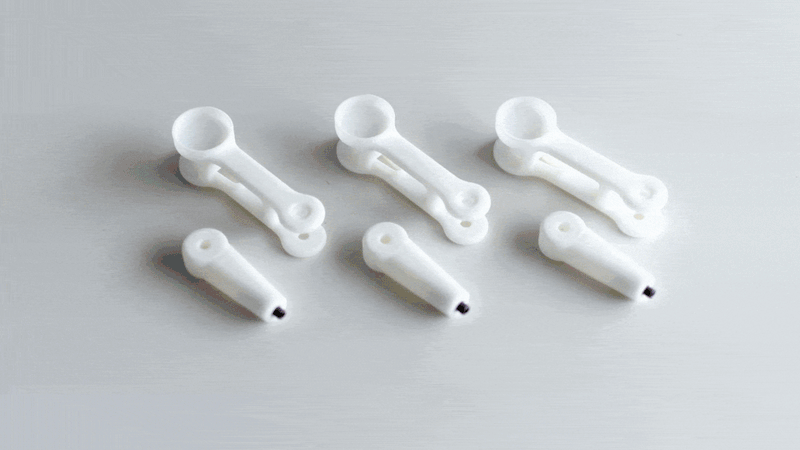
[picture p18: original/web_captures/Manual – BaBot_files/arms-ezgif.com-crop.gif]
Assemble the Arms
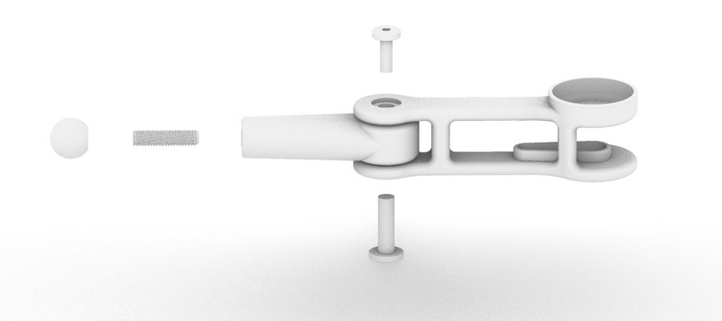
[picture p19: original/web_captures/Manual – BaBot_files/manual45.png]
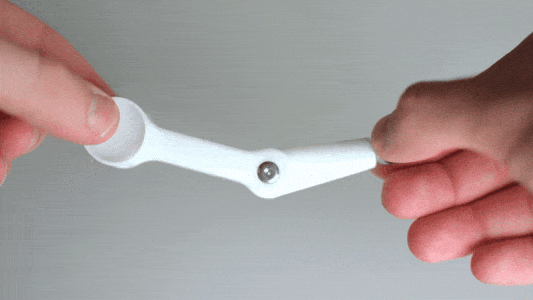
[picture p20: original/web_captures/Manual – BaBot_files/DSC_0209-ezgif.com-optimize.gif]
    
2. 02

### Access the Motors

  Use the provided tool to unscrew the electronic circuit from the base by removing 3 small screws. Carefully extract the motors without damaging the cables.
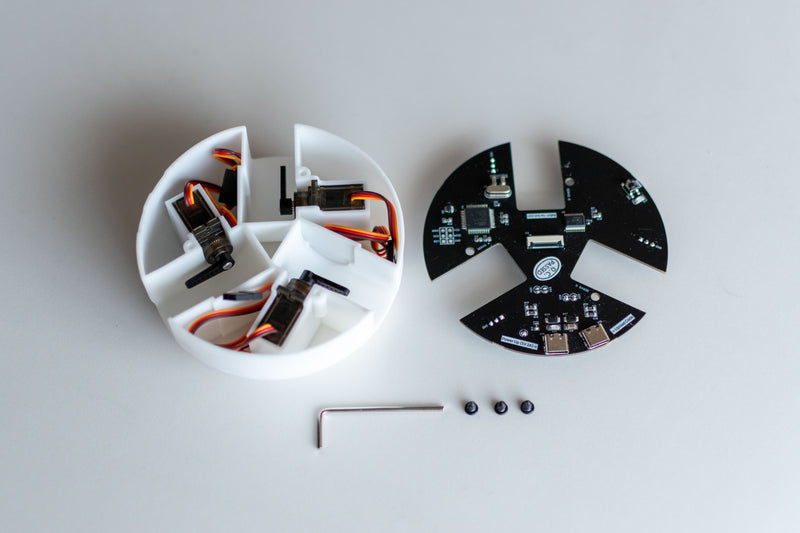
[picture p21: original/web_captures/Manual – BaBot_files/manual20.jpg]
Access the Motors
  
3. 03

### Fit Arms to Motors

  Insert the motor arm tip (black part) into the hole, rotate and push the remaining motor into place. Repeat for each of the three motors.
  Important
  Never force a servo by rotating the arm manually, as this may damage or break the internal gears.
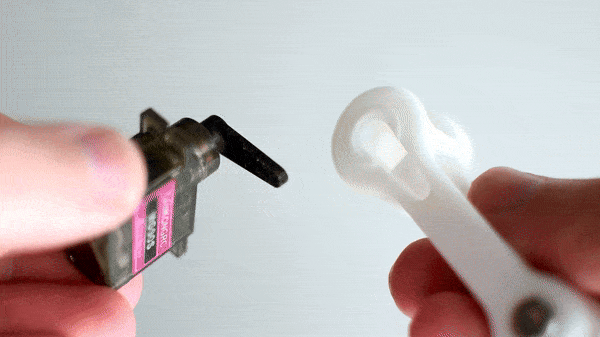
[picture p22: original/web_captures/Manual – BaBot_files/DSC_0216-ezgif.com-optimize.gif]
Fit Arms to Motors
  
4. 04

### Replace Motors in Base

  Push each motor completely down into position.
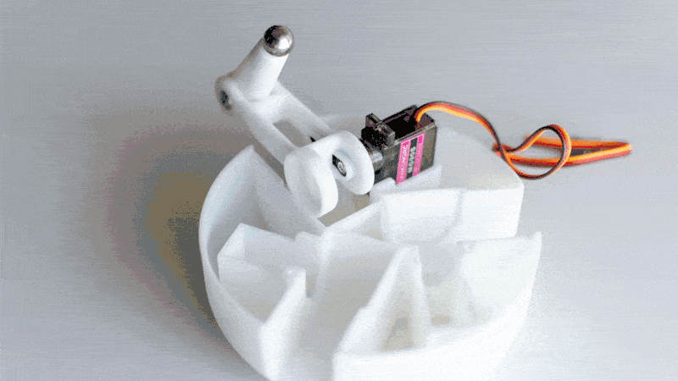
[picture p23: original/web_captures/Manual – BaBot_files/servoInnBase-ezgif.com-crop-1.gif]
Replace Motors in Base
  
5. 05

### Connect Motor Cables

  Plug each connector with the correct orientation. Reverse connections will prevent the motors from functioning properly. Place the circuit back into the base, bend the motor cables into the gaps, align the USB-C ports with the notches, and secure with the three screws.
  Important
  Align the USB-C ports with the notches of the base
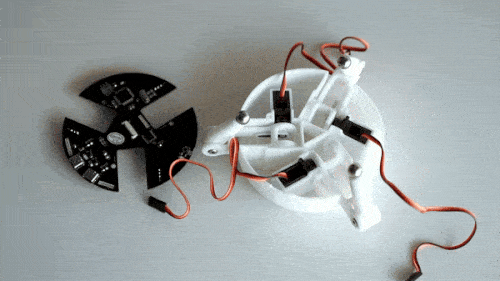
[picture p24: original/web_captures/Manual – BaBot_files/DSC_0222-ezgif.com-optimize.gif]
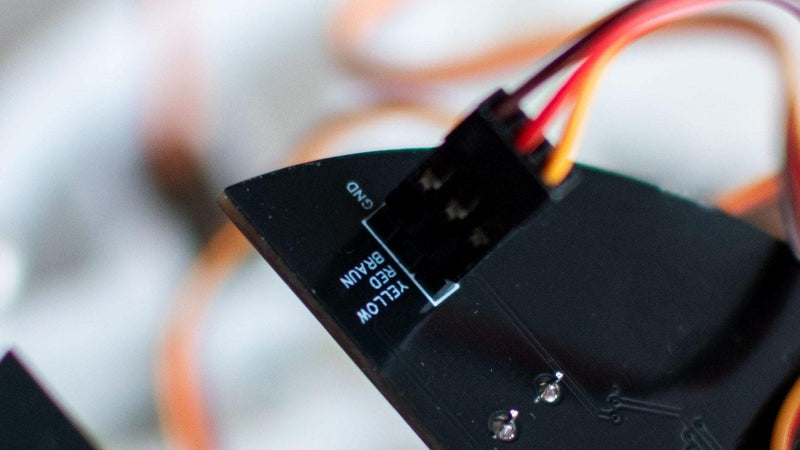
[picture p25: original/web_captures/Manual – BaBot_files/manual27-1-edited-1536x864.jpg]
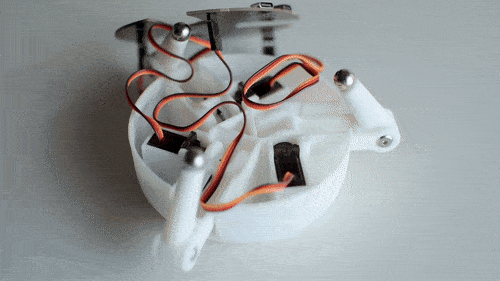
[picture p26: original/web_captures/Manual – BaBot_files/DSC_0227-ezgif.com-optimize-1.gif]
    
6. 06

### Calibrate Motors

  Follow these steps carefully to calibrate the three servo positions:
  1. Connect the PCB "Power" port to a computer or USB-C phone charger.
  2. Triple-press the button — servo A will move lower than the others.
  3. Press the button repeatedly to move the arm down by 1° increments.
  4. Continue until the arm is horizontal.
  5. Long-press the button for 2 seconds to confirm calibration for servo A.
  6. Servo B automatically positions itself — repeat the adjustment process.
  7. Servo C automatically positions itself — repeat the adjustment process.
7. 07

### Attach Magnets

  Tape the magnets onto the circuit holder. Make sure to double-check the orientation of the magnets.
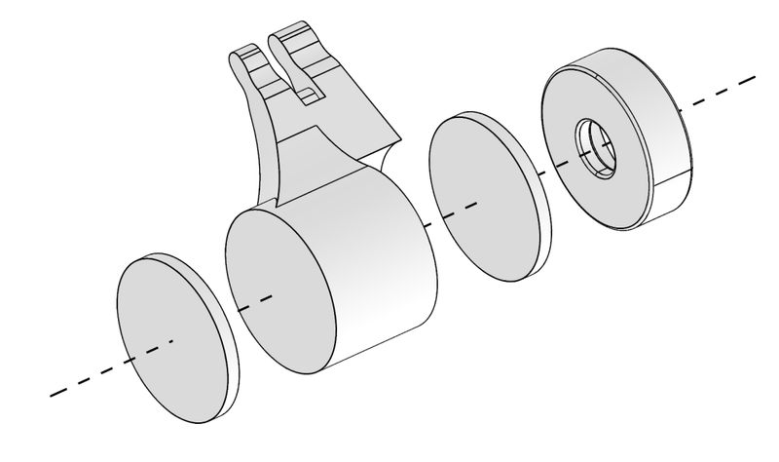
[picture p27: original/web_captures/Manual – BaBot_files/image-1-1024x607.png]
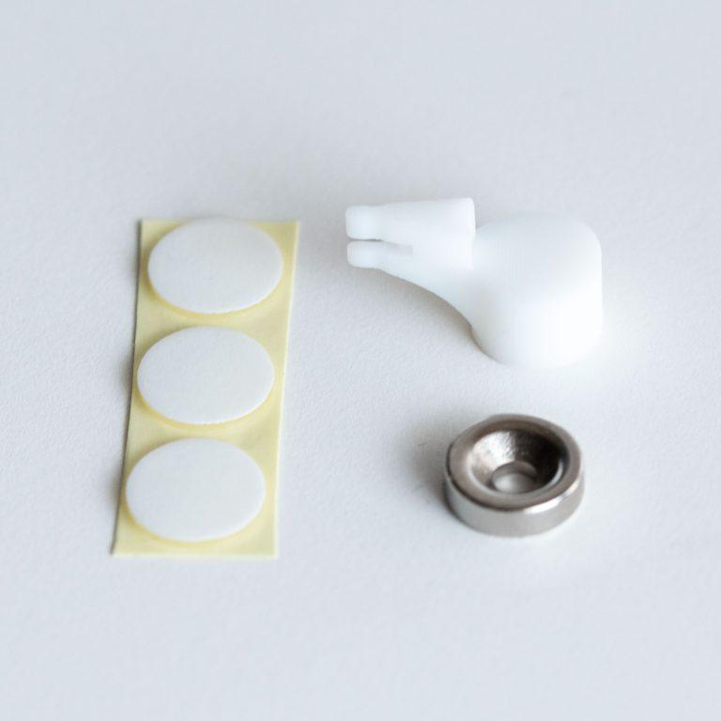
[picture p28: original/web_captures/Manual – BaBot_files/manual34-4-768x768.jpg]
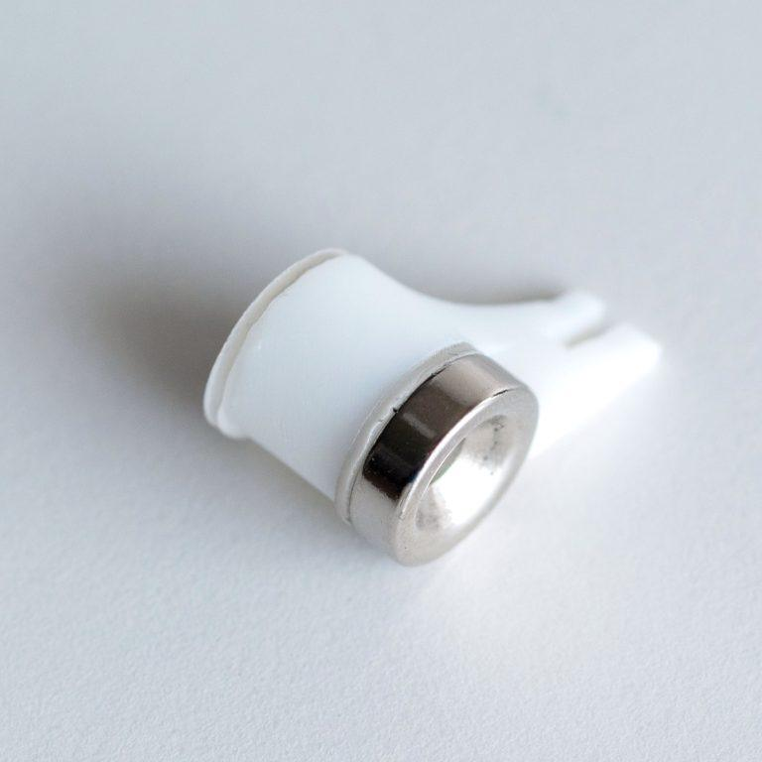
[picture p29: original/web_captures/Manual – BaBot_files/manual36-2-768x768.jpg]
    
8. 08

### Assemble the Platform

  Remove the protective film from the transparent PMMA plate. Tape the two circuit holders onto the plate, slide the circuit notches into the holders securely, then tape the final holder to lock the assembly in place.
  Important
  When peeling off the protective film, make sure to go slowly to avoid breaking the plate.
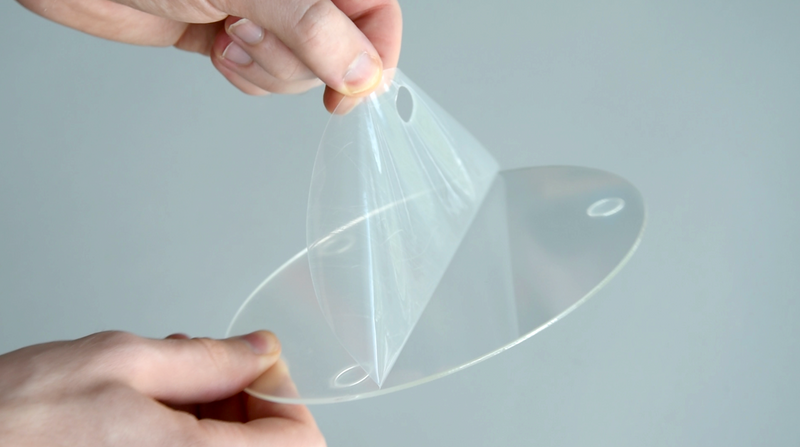
[picture p30: original/web_captures/Manual – BaBot_files/Capture_d_ecran_2026-06-06_a_20.22.22_f86ea069-752f-47be-812d-94424f9cfcec.png]
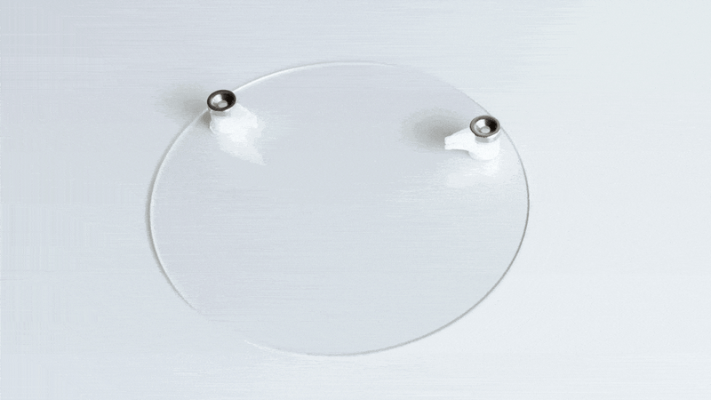
[picture p31: original/web_captures/Manual – BaBot_files/ezgif.com-optimize-1-1.gif]
   
9. 09

### Connect Flat Cable (First End)

  Open the locking connector by gently lifting the lever. Slide the flat cable fully into the connector, ensuring it is fully inserted and properly aligned. Close the lever to lock it in place.
  Important
  Make sure the blue side of the flat cable is facing up.
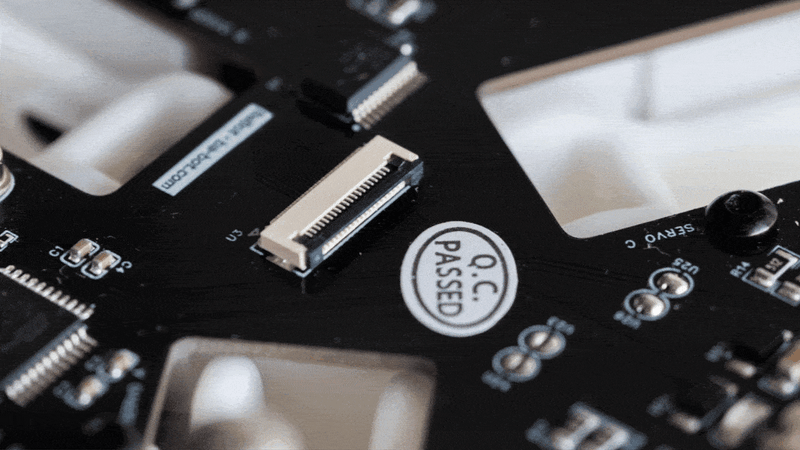
[picture p32: original/web_captures/Manual – BaBot_files/ezgif.com-optimize-1-copie.gif]
Connect Flat Cable (First End)
  
10. 10

### Connect Flat Cable (Second End)

  Repeat the same process for the second circuit connection — open the lever, insert the flat cable fully, close the lever to lock.
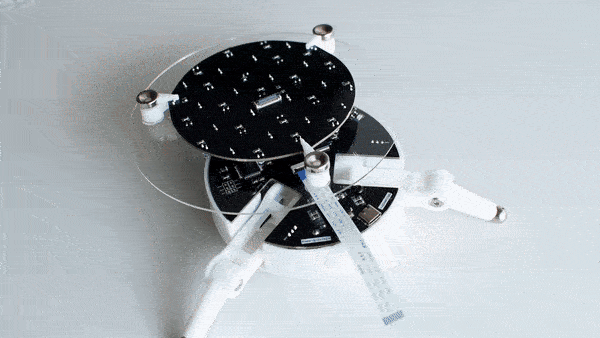
[picture p33: original/web_captures/Manual – BaBot_files/DSC_0248-ezgif.com-optimize.gif]
Connect Flat Cable (Second End)
  
11. 11

### Assembly Complete

  Connect USB-C power to the "Power Up" connector. The platform will move to a horizontal position automatically and the red LED will blink. Place the ball on the platform — BaBot will start balancing.
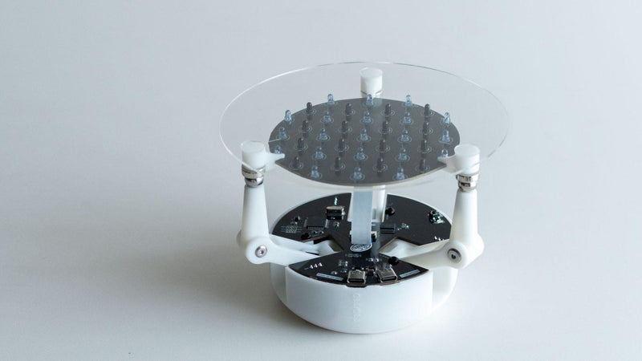
[picture p34: original/web_captures/Manual – BaBot_files/manual42-1-edited-1536x864.jpg]
Assembly Complete
  

## How to Use

Connect a USB-C cable to the "Power Up" connector using a computer or phone charger. The platform moves to horizontal automatically and the red LED blinks. Place the ball on the platform to begin.

Blinking

BaBot is ready and waiting for the ball. Place the ball on the platform to begin.

Off

BaBot is powered off. Press the button once to switch it on or off.

Solid Red

Ball detected — the control loop is active and balancing.

Infrared light sensitivity

BaBot is highly sensitive to infrared light. It cannot be used outdoors or in very bright sunlight, as infrared interference from the sun can make the sensors completely unresponsive. For best performance, use BaBot indoors under controlled lighting conditions.

## Troubleshooting

### 1. Check lighting conditions

Perform tests in a room with limited natural light. Excess ambient infrared from sunlight or bright incandescent bulbs interferes with the sensors. This is the most common issue — try a different room first.

### 2. Verify smooth motor operation

If an arm is stuck or not rotating, confirm that no part of the arm is rubbing against the base. If it is, use sandpaper to create a small gap and ensure there is no friction.

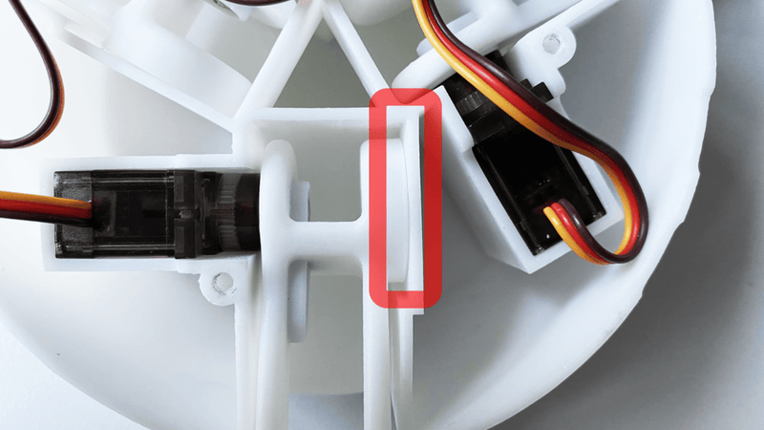
[picture p35: original/web_captures/Manual – BaBot_files/IMG_5073-edited-1536x864.png]
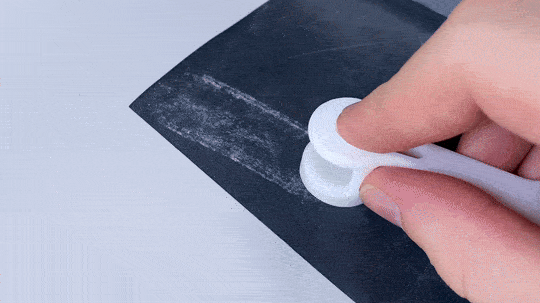
[picture p36: original/web_captures/Manual – BaBot_files/IMG_5072-ezgif.com-optimize.gif]
 

### 3. Re-upload the firmware

If the LED continues blinking when the ball is placed, or if the ball is detected but fails to stabilize after 2–3 seconds, re-upload the firmware:

1. Download and install Arduino IDE from arduino.cc/en/software.
2. Download the BaBot code file from GitHub (https://github.com/JohanLink/BABOT).
3. Connect BaBot to your computer using the "Upload Code" USB port.
4. (Step 1, 2 & 3 in the image below) Open the Library Manager, search for CD74HC4067 and install it.
5. (Step 4 i the image below) Select Arduino Leonardo as the board type.
6. (Step 5&6 i the image below) Click Upload and wait for "Done uploading" (under 20 seconds).
7. Disconnect USB, then reconnect to the "Power Up" port before testing.

Upload error: no upload port provided

Make sure you have selected Arduino Leonardo as the board type, and that BaBot is connected via the Upload Code port (not the Power Up port).

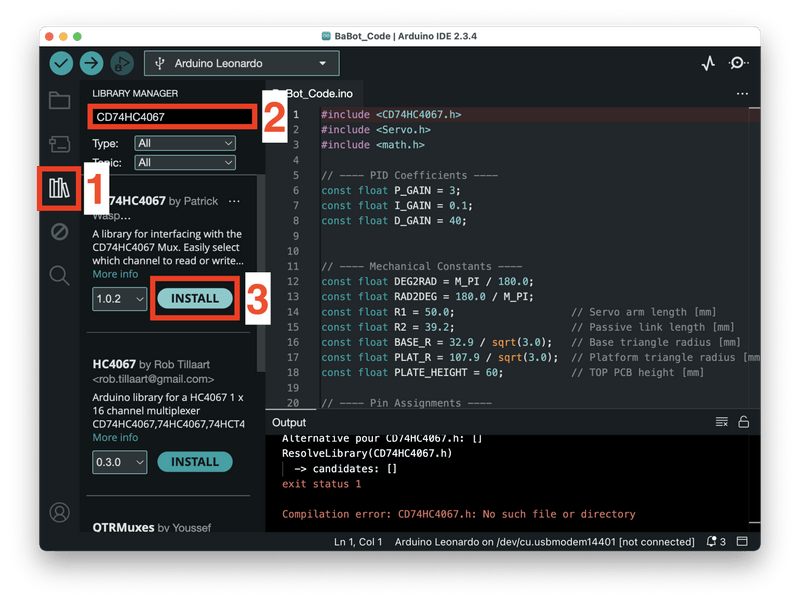
[picture p37: original/web_captures/Manual – BaBot_files/Capture-decran-2025-08-02-a-15.43.03-1536x1158.png]
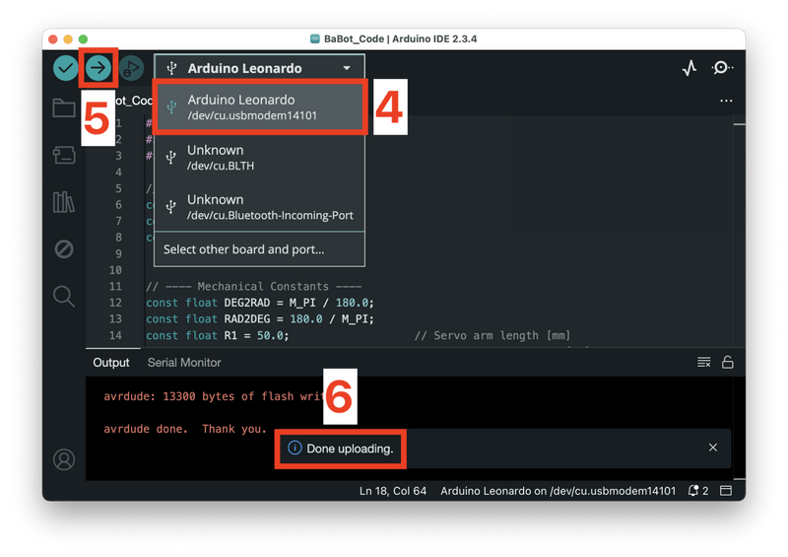
[picture p38: original/web_captures/Manual – BaBot_files/Capture-decran-2025-08-02-a-18.03.20-1536x1085.png]
 

How It Works → (https://ba-bot.com/pages/how-it-works) Open Source → (https://ba-bot.com/pages/open-source)

BaBot (https://ba-bot.com/)

A compact robot that balances a ball using PID control.
Open-source, beginner-friendly, and built to teach real engineering.

Designed in Switzerland 🇨🇭 BaBot, Lausanne, Switzerland
info@ba-bot.com

© 2026 BaBot. All rights reserved.

@babot_project (https://www.instagram.com/babot_project/)

BaBot Robotics Kit $169.00 Free shipping Stock is running low

Order Now → (https://ba-bot.com/pages/manual#order)

### Wait — don't miss out.

Get build updates & a shipping notification when your kit is on its way.

Keep me posted No thanks, I'll pass.
