Hemlock-white/Babot_revisioned_Mechatronics_TermProject/original/web_captures/BaBot_ Build Your Own Ball-Balancing Robot——Base Board - Share Project - PCBWay_files/094435860.jpg

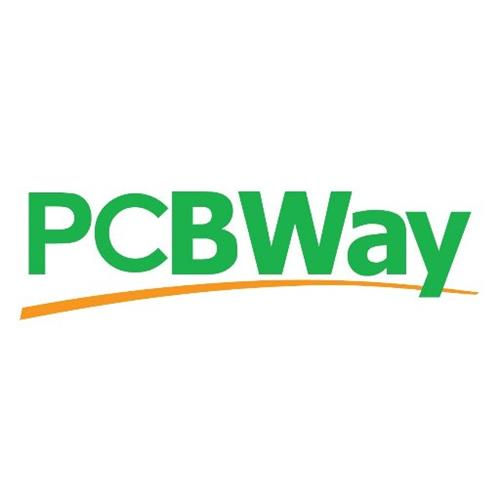
original/web_captures/BaBot_ Build Your Own Ball-Balancing Robot——Base Board - Share Project - PCBWay_files/094435860.jpg
