Hemlock-white/Babot_revisioned_Mechatronics_TermProject/original/web_captures/BaBot_ Build Your Own Ball-Balancing Robot——Base Board - Share Project - PCBWay_files/103115377ea7bd2c147f043f098b3ab2a716ea1d74848s.png

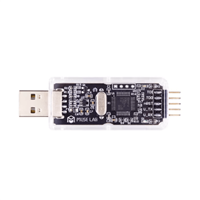
original/web_captures/BaBot_ Build Your Own Ball-Balancing Robot——Base Board - Share Project - PCBWay_files/103115377ea7bd2c147f043f098b3ab2a716ea1d74848s.png
