Hemlock-white/Babot_revisioned_Mechatronics_TermProject/original/web_captures/BaBot_ Build Your Own Ball-Balancing Robot——Base Board - Share Project - PCBWay_files/153301249ef2749a84f184189812db64023a778241376s.jpg

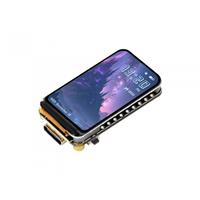
original/web_captures/BaBot_ Build Your Own Ball-Balancing Robot——Base Board - Share Project - PCBWay_files/153301249ef2749a84f184189812db64023a778241376s.jpg
