Hemlock-white/Babot_revisioned_Mechatronics_TermProject/original/web_captures/BaBot_ Build Your Own Ball-Balancing Robot——Base Board - Share Project - PCBWay_files/171344694b0766f1abc644e71aebd91b94d007c530481s.png

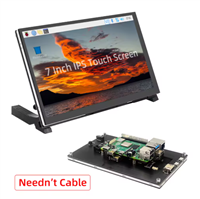
original/web_captures/BaBot_ Build Your Own Ball-Balancing Robot——Base Board - Share Project - PCBWay_files/171344694b0766f1abc644e71aebd91b94d007c530481s.png
