Hemlock-white/Babot_revisioned_Mechatronics_TermProject/original/web_captures/BaBot_ Build Your Own Ball-Balancing Robot——Plate Board - Share Project - PCBWay_files/034717152aedc6067e5254edbad45339bc1c97da36656m.png

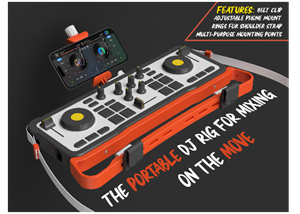
original/web_captures/BaBot_ Build Your Own Ball-Balancing Robot——Plate Board - Share Project - PCBWay_files/034717152aedc6067e5254edbad45339bc1c97da36656m.png
