Hemlock-white/Babot_revisioned_Mechatronics_TermProject/original/web_captures/BaBot_ Build Your Own Ball-Balancing Robot——Plate Board - Share Project - PCBWay_files/045054995df099dc10765410585acad05acca627b8065m.gif

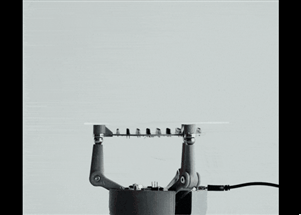
original/web_captures/BaBot_ Build Your Own Ball-Balancing Robot——Plate Board - Share Project - PCBWay_files/045054995df099dc10765410585acad05acca627b8065m.gif
