Hemlock-white/Babot_revisioned_Mechatronics_TermProject/original/web_captures/BaBot_ Build Your Own Ball-Balancing Robot——Plate Board - Share Project - PCBWay_files/102611478e67f4d70616b4426855f1d92f3470c537635.png

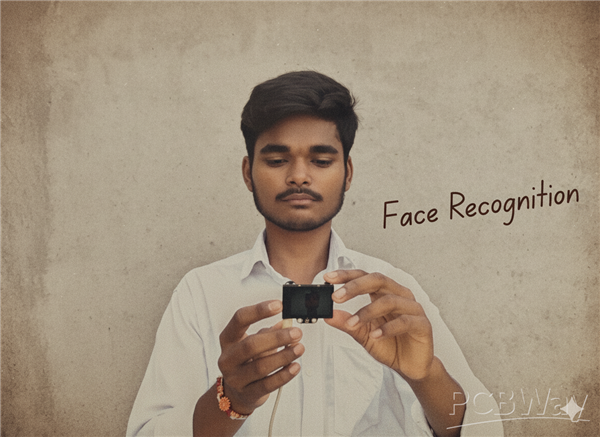
original/web_captures/BaBot_ Build Your Own Ball-Balancing Robot——Plate Board - Share Project - PCBWay_files/102611478e67f4d70616b4426855f1d92f3470c537635.png
