Hemlock-white/Babot_revisioned_Mechatronics_TermProject/original/web_captures/BaBot_ Build Your Own Ball-Balancing Robot——Plate Board - Share Project - PCBWay_files/102814804d9c52b80c6634db59a0e8d1d91cf65d41121s.png

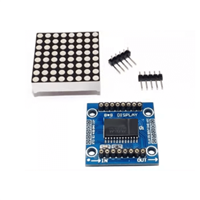
original/web_captures/BaBot_ Build Your Own Ball-Balancing Robot——Plate Board - Share Project - PCBWay_files/102814804d9c52b80c6634db59a0e8d1d91cf65d41121s.png
