Hemlock-white/Babot_revisioned_Mechatronics_TermProject/original/web_captures/BaBot_ Build Your Own Ball-Balancing Robot——Plate Board - Share Project - PCBWay_files/142921693c16e72abf3cc4d3ca05e5b9ba7a7fe9a1745m.png

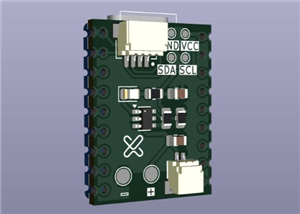
original/web_captures/BaBot_ Build Your Own Ball-Balancing Robot——Plate Board - Share Project - PCBWay_files/142921693c16e72abf3cc4d3ca05e5b9ba7a7fe9a1745m.png
