Hemlock-white/Babot_revisioned_Mechatronics_TermProject/original/web_captures/BaBot_ Build Your Own Ball-Balancing Robot——Plate Board - Share Project - PCBWay_files/171732221e23865453ea84fcdb649baa0e304abbb3844.jpeg

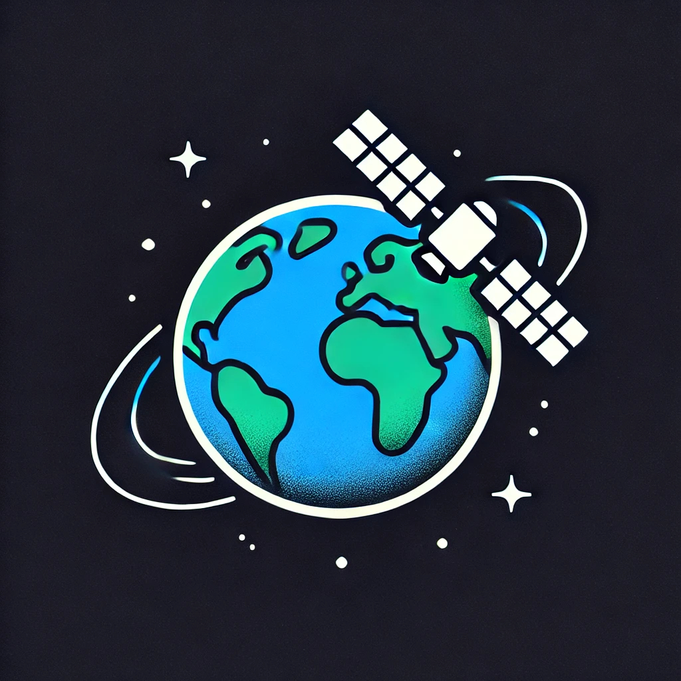
original/web_captures/BaBot_ Build Your Own Ball-Balancing Robot——Plate Board - Share Project - PCBWay_files/171732221e23865453ea84fcdb649baa0e304abbb3844.jpeg
