Hemlock-white/Babot_revisioned_Mechatronics_TermProject/original/web_captures/BaBot_ Build Your Own Ball-Balancing Robot——Plate Board - Share Project - PCBWay_files/223525942e28c4e7c49f44c348a5cdbe1f78ff9fe6272.png

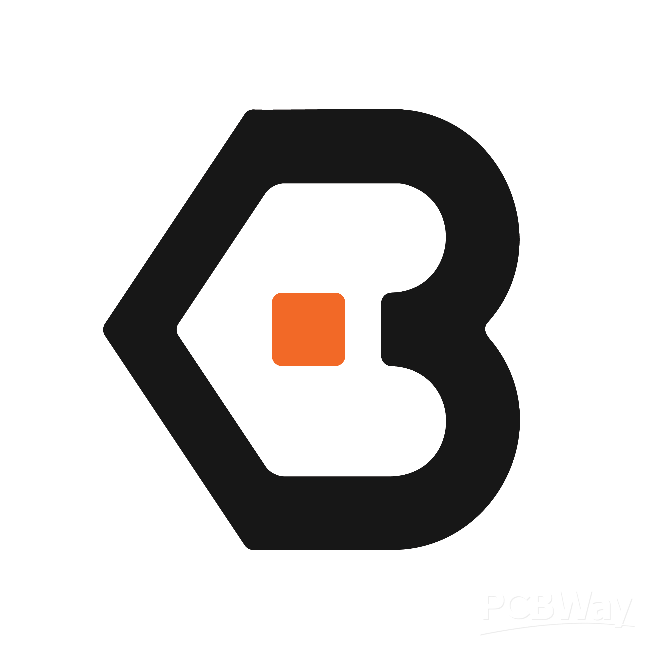
original/web_captures/BaBot_ Build Your Own Ball-Balancing Robot——Plate Board - Share Project - PCBWay_files/223525942e28c4e7c49f44c348a5cdbe1f78ff9fe6272.png
