Hemlock-white/Babot_revisioned_Mechatronics_TermProject/original/web_captures/BaBot_ Build Your Own Ball-Balancing Robot——Plate Board - Share Project - PCBWay_files/0729134641d718c8aabb04d93b14be14ac8c7b55d5250m.png

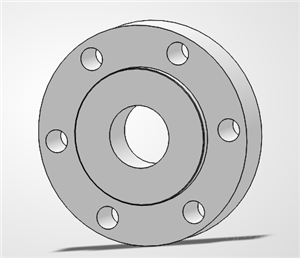
original/web_captures/BaBot_ Build Your Own Ball-Balancing Robot——Plate Board - Share Project - PCBWay_files/0729134641d718c8aabb04d93b14be14ac8c7b55d5250m.png
