Hemlock-white/Babot_revisioned_Mechatronics_TermProject/original/web_captures/BaBot_ Build Your Own Ball-Balancing Robot——Plate Board - Share Project - PCBWay_files/1705101527f85838f17fc4d5f8277c15a2af111d74811s.jpg

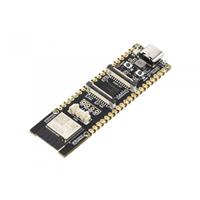
original/web_captures/BaBot_ Build Your Own Ball-Balancing Robot——Plate Board - Share Project - PCBWay_files/1705101527f85838f17fc4d5f8277c15a2af111d74811s.jpg
