Hemlock-white/Babot_revisioned_Mechatronics_TermProject/original/web_captures/BaBot_ Build Your Own Ball-Balancing Robot——Plate Board - Share Project - PCBWay_files/1749054278b80c0f6bc3e40f7a75a34af4c3a96c65034s.png

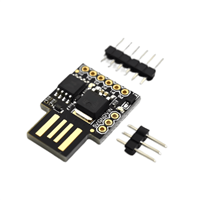
original/web_captures/BaBot_ Build Your Own Ball-Balancing Robot——Plate Board - Share Project - PCBWay_files/1749054278b80c0f6bc3e40f7a75a34af4c3a96c65034s.png
