Hemlock-white/Babot_revisioned_Mechatronics_TermProject/original/web_captures/BaBot_ Build Your Own Ball-Balancing Robot——Plate Board - Share Project - PCBWay_files/17484691148d7e4fddeff4be28a3f080ffe64b5713450m.png

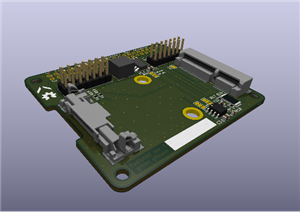
original/web_captures/BaBot_ Build Your Own Ball-Balancing Robot——Plate Board - Share Project - PCBWay_files/17484691148d7e4fddeff4be28a3f080ffe64b5713450m.png
