Hemlock-white/Babot_revisioned_Mechatronics_TermProject/original/web_captures/BaBot_ Build Your Own Ball-Balancing Robot——Plate Board - Share Project - PCBWay_files/19363854909dcb53dcf3841c189ad7ef9466336e05188.jpg

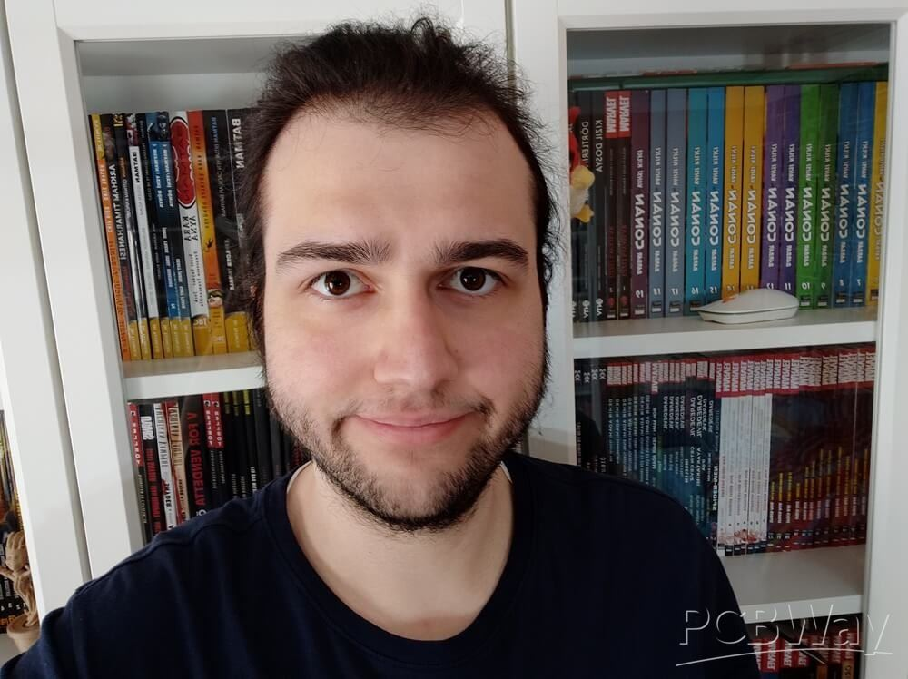
original/web_captures/BaBot_ Build Your Own Ball-Balancing Robot——Plate Board - Share Project - PCBWay_files/19363854909dcb53dcf3841c189ad7ef9466336e05188.jpg
