Hemlock-white/Babot_revisioned_Mechatronics_TermProject/software/test_ir_angle/README.md

# 單顆未知 IR 發射管的發射角測試

這個實驗用兩塊**分開的麵包板**。Arduino Micro 負責點亮／熄滅待辨認的 IR LED；Arduino Uno 讀取 PT204-6B 光電晶體。兩板之間只傳光，**不需連接任何訊號線或 GND 線**。光電晶體先量關燈背景，再量開燈讀值；開燈減背景後，與正前方讀值比較。

程式：

- [發射端 `emitter_micro.ino`](emitter_micro/emitter_micro.ino)：燒到 **Arduino Micro**。
- [接收端 `receiver_uno.ino`](receiver_uno/receiver_uno.ino)：燒到 **Arduino Uno**。

兩個 Serial Monitor 都設 **115200 baud**、行尾選 **Newline**。Arduino IDE 可以開兩個視窗，分別選兩塊板自己的 COM 埠；發射端選 **Arduino Micro**，接收端選 **Arduino Uno**。每次上傳前確認板型與 COM 埠都對應到手上的板子。兩板分別由 USB 供電，接收端用 Uno 的 **5V** 腳供 PT204-6B。

## 1. 斷電接線

所需：一顆待辨認 IR LED、**330 Ω 電阻**、PT204-6B、一顆 **10 kΩ 電阻**、兩塊麵包板、杜邦線、量角器／印有角度的紙、兩條 USB 線。先拔掉兩板 USB，完成接線後再通電。

### Arduino Micro：發射端

```text
Arduino Micro D9 ─── 330 Ω ─── IR LED 陽極 A
Arduino Micro GND ──────────── IR LED 陰極 K
```

發射管若是未剪腳的新件，長腳通常是陽極；剪過腳的零件不要靠長短判斷，先用萬用表二極體檔辨認。**330 Ω 不可省略，也不要將 LED 直接跨接 D9 與 GND。**以 5 V、LED 正向壓降約 1.2 V 估計，電流約 `(5−1.2)/330 ≈ 11.5 mA`。Arduino Micro 的 D9 只驅動這**一顆** LED。`on` 開燈、`off` 關燈；`on` 後 120 秒自動關閉。IR 光通常肉眼看不到。

### Arduino Uno：接收端

```text
Uno 5V ───────── PT204-6B Collector，C（資料表腳 ②）
Uno A0 ───┬───── PT204-6B Emitter，E（資料表腳 ①）
                └─ 10 kΩ ─── Uno GND
```

依 [PT204-6B 資料表的封裝圖](../../hardware/Electronincs_Datasheet/PT204-6B.PDF)及外殼定位標記辨認 **① E、② C**；不要只憑長短腳或從相反方向看圖就猜腳位。10 kΩ 是必要的電流轉電壓負載，缺少它 A0 會浮接。這個接法下光較強時 A0 通常較高。接 PT204 的 C 時用 Uno 的 **`5V`**，不要用 **`VIN`**。兩板只用各自 USB 供電，沒有外接電源，也不把 Arduino Micro 的 D9 接到 Uno A0。兩板只用各自 USB 供電，沒有外接電源。

## 2. 上電先確認電路

1. 燒好兩支程式，開各自的 Serial Monitor。發射端開機應顯示 **Initially OFF**。接收端顯示可用指令。
2. 兩個透鏡相對，距離約 **10–20 cm**，先讓 LED 正對 PT204-6B。接收端輸入 `watch`，記下 IR 關燈時的 `ADC`；發射端輸入 `on`，接收端 `ADC` 應上升；發射端輸入 `off`，ADC 應回落。接收端輸入 `stop`。
3. 若開關燈後完全不變，先查 LED 極性、330 Ω、D9、PT204 的 C/E、10 kΩ 與 A0。可以在發射端 `on` 時量 **330 Ω 兩端壓降**；約 3–4 V 表示大約 9–12 mA 流過該支路。手機相機看不到 IR 不能單獨判斷 LED 壞掉。
4. 若正前方開燈的 `ADC` **達到 800 或更高**，程式會拒絕儲存角度基準：接收管可能在 ADC 尚未達 1023 前就接近飽和。先拉遠距離，或斷電後把 10 kΩ 換成較小的負載，目標可先讓開燈讀值落在約 **200–700**。若開燈扣背景少於約 **20 ADC counts**，調整正對方向或拉近。選定距離與負載後，**整組角度測試都保持不變**。800 是保守的實驗門檻，並非元件保證線性的界線。

`watch` 只用於找方向、確認電路；正式比較請用下面的 `dark`、`center`、`light`，由程式算背景差。

## 3. 正式測 0°、17.5°、25°

固定接收端的 PT204-6B 與兩個透鏡之間的距離，在桌上畫一條 LED 指向 PT204 的 **0°** 線。之後只旋轉發射端，盡量讓**LED 透鏡中心停在原處**，避免一邊轉一邊改變距離；每個角度都等麵包板停止晃動後再讀。接收端的透鏡始終朝向發射端原來的位置。可以在室內固定照明下測，避免強烈陽光直射或有人影經過。

| 角度 | 發射端 Serial 指令 | 接收端 Serial 指令 | 做什麼 |
| --- | --- | --- | --- |
| 0° | `off` | `dark` | 記下環境光背景。 |
| 0° | `on` | `center` | 記下正前方淨訊號，設為 **100%**。 |
| 約 17.5° | `off` | `dark` | 轉動發射端後，重新記背景。 |
| 約 17.5° | `on` | `light` | 程式顯示 `net` 與相對正前方的百分比。 |
| 約 25° | `off` | `dark` | 再次轉動發射端、重新記背景。 |
| 約 25° | `on` | `light` | 程式顯示 `net` 與相對百分比。 |

`on` 若已超過 120 秒會自動熄滅；每次 `light` 或 `center` 前可用發射端 `status` 確認仍為 **ON**，必要時再輸入 `on`。角度以 **+17.5°、+25°** 做一輪，最好也做 **−17.5°、−25°**；兩側結果若差很多，通常是透鏡未置中、旋轉時位置移動、環境光改變或封裝／麵包板遮擋，先修正治具再判讀。

### 怎麼讀結果

接收端算 `net = light ADC − dark ADC`；`relative to center = net / 0° net × 100%`。此比例只在接收管未飽和、相同電阻與距離、發射電流相同時才適合用來估角度。例如正前方 `net=200`，偏轉後 `net=100`，該角度約為正前方的 **50%**。`sample-range` 是同一次取樣的最小與最大 ADC，範圍太寬表示讀值不穩；重測並檢查固定方式、環境光和接線。

- [IR204C-A 資料表](../../hardware/Electronincs_Datasheet/IR204C-A.PDF)：`2θ½ = 35°`，所以理想情況下在 **±17.5°** 左右約剩 50%。
- [IR204/H60 原廠資料表](https://en.everlight.com/wp-content/plugins/ItemRelationship/product_files/pdf/IR204-H60.pdf)：`2θ½ = 50°`，在 **±25°** 左右約剩 50%。

這是依資料表的**典型半強度角**作分類，測到哪邊接近 50% 就「較像」哪一款；它不能證明裸 LED 的確切料號。距離、接收管本身的角度響應、反射、LED 個體差異與量角誤差都會影響讀值。兩款的順向電壓範圍相近，單用萬用表二極體檔**無法**區分型號。若要百分之百確認，需保留原包裝標籤或供應商可追溯資料。

## 4. 結束

發射端輸入 `off`，接收端輸入 `stop`，確認發射端 `status` 顯示 **OFF**，再拔除 USB。`reset` 只清除 Uno 記憶體中的背景和 0° 基準，不改變電路或 LED。
