Hemlock-white/Babot_revisioned_Mechatronics_TermProject/software/test_code_base/README.md

# BaBot Base PCB 測試程式

用 Arduino IDE 開啟 [`test_code_base.ino`](test_code_base.ino)，板子選 **Arduino Micro**，確認 IDE 可使用 **Servo** 函式庫，燒錄後開啟 **115200 baud** Serial Monitor，行尾選 **Newline**。此程式不執行平衡控制、不寫 EEPROM，開機不會啟動伺服；輸入 `help` 可看指令。程式內每段測試均附有目的、接線及預期結果註解。

| 階段 | 指令／工具 | 測試與預期結果 |
| --- | --- | --- |
| 完全斷電 | 萬用電表 | `+5V_LOGIC` 與 `+5V_SERVO` 不短路；確認 J1-1 是外部 `+5V_SERVO`、J1-2 是 GND。 |
| 只接 Micro USB | 萬用電表 | 量 U3-19 (`+5V_LOGIC`) 對 U3-20 (GND)，應接近 USB 的 5 V；此時尚未接 J1，勿把 U3-18 (`+5V_SERVO`) 的浮動電壓當成供電正常。若無邏輯電源，先停下來檢查 USB、Micro 與焊點。 |
| 只接 Micro USB | `led blink` | Base 的 U15 閃三次；不亮查 D8、LED 極性、R10、GND。 |
| 只接 Micro USB | `button`，按放 SW1，最後 `stop` | 放開顯示 `RELEASED (0)`，按下顯示 `PRESSED (1)`；測 SW1、R7、A1。 |
| 只接 Micro USB | `ir on` / `ir off` | 量 Base U3-17 (`IR_LED_CONTROL`) 對 GND，分別約為邏輯 5 V / 0 V；`ir on` 最多 5 秒自動關閉。此測試不涵蓋尚未安裝的 Plate。 |
| Plate 拔開；USB + **第二顆** 10 kΩ 測試電阻 | `cal 0`，最後 `stop` | 另用一顆電阻從 U3-19 (`+5V_LOGIC`) 接到 U3-1 (`PT00`)。RV1 焊盤的負載約 10 kΩ 時 ADC 約 **524/1023**。若焊盤已改為固定 10 kΩ，這是路徑檢查，沒有可轉的 RV1。 |
| USB + 同一顆測試電阻 | `mux 0` 或 `scan` | 測 4067 選擇線、對應 PT 通道及 A0。要驗證別的 PT 腳，**先斷電**再將電阻移到該腳，然後輸入 `mux N`。未接電阻的通道浮接，數字不具判斷意義。 |
| USB + J1 外部穩壓 5 V | `servo a 1500`，再試 `1400` / `1600`；B/C 同理；最後 `servo off` | 先用萬用電表量 J1 和 H1–H3 電源/地，之後一次只接一顆無連桿伺服。對應 H1/H2/H3 應小幅動作；移動幅度和方向因伺服而異。 |

伺服測試使用**角度定位型**伺服（例如一般 SG90），指令中的 1400–1600 µs 是鄰近中立點的位置命令。連續旋轉型伺服會把這些脈寬解讀成速度／方向，無法用來確認平台的目標角度，也不適合現有平衡韌體。先確認機械連桿與舵盤可自由活動，再決定所需扭力；不要在裝妥機構前用這段程式作大角度掃動。

校準治具連接前務必斷電、**拔開 Plate**，用另一顆 10 kΩ **電阻**而非導線跨接 U3-19 與 U3-1；**U3-18 是伺服電源，不能接到 PT00**。若外加電阻實測值與 10 kΩ 不同，修改程式中的 `TEST_RESISTOR_OHMS`。先在**完全斷電**時量 RV1-1 對 GND 約 10 kΩ，再用 `cal 0` 驗證整條 mux/ADC 路徑。若 Plate 已接上，或沒有額外那顆測試電阻，`cal` 顯示的「估算電阻」**不具意義**；ADC 在 0–數百間跳動也不能據此判定焊上的 10 kΩ 錯誤。固定 10 kΩ 是初始負載；Plate 裝好後應以實際 IR-off/IR-on 讀數評估靈敏度。**通電時不要使用萬用電表的電阻檔**；改用直流電壓檔量 U3-19、U3-1 和 A0 對 GND 的電壓。

若已把 RV1 改焊為固定 10 kΩ，可用這組預測值定位故障（Plate 拔開、J1 不供電、**第二顆** 10 kΩ 電阻已跨接 U3-19 到 U3-1、只接 Micro USB，輸入 `cal 0`）：

| 量測點／讀數 | 預期 | 若不符，先檢查 |
| --- | --- | --- |
| 斷電，RV1-1 到 RV1-3 | 約 10 kΩ | 固定電阻與兩個焊點。 |
| 通電，U3-19 對 U3-20，電壓檔 | 接近 USB 邏輯 5 V | Micro 5 V、U3 腳號與焊點。 |
| 通電，U3-1 對 U3-20，電壓檔 | 約 2.5–2.6 V | 若接近 0 或 5 V，確認**第二顆**電阻和正確的 U3 腳號。 |
| 通電，Micro A0／U1_SIG 對 GND，電壓檔 | 約 2.5–2.6 V | U3-1 正常但 A0 不正常：查 4067 模組方向、C0/SIG/EN、焊點和 R18。 |
| `cal 0` | ADC 約 524/1023，應大致穩定 | A0 電壓正常而 ADC 不符：查 Micro A0 腳位、燒錄板型或程式。 |

以上電壓是 5 V、10 kΩ 外加治具與板上 500 Ω + 10 kΩ 負載的**估算**；實際 USB 電壓、電阻容差和 4067 導通電阻會造成少許差異。若 Plate 接著，這些電壓預測不適用。依 [Fluke 的電阻量測說明](https://www.fluke.com/en-gb/learn/blog/digital-multimeters/how-to-measure-resistance)，量 Ω 前必須先關閉電路電源。

若 `cal 0` **連續顯示 1023**，A0 可能真的接近邏輯 5 V，也可能因訊號線中斷而浮接；單靠 ADC 無法區分。先以 DC 電壓檔量 U3-1 與 R18-1／A0 對 U3-20：若 U3-1 約 5 V 而 A0 約 0 V，優先查 4067 的 `PT00/C0`、`SIG`、`EN` 和模組方向；若 A0 約 5 V，優先查 R18 到固定 10 kΩ 的接點與 GND。**斷電**後再量 RV1-3 對 U3-20 是否導通、R18-1 對 U3-20 是否約 10.5 kΩ。只量固定電阻兩隻腳為 10 kΩ，尚不能證明它的接地焊點真的連到 PCB 的 GND。

伺服測試前先確認 J1 極性與電源能力。Micro USB 供 `+5V_LOGIC`；J1 供 `+5V_SERVO`，兩個正電源保持分開、GND 共用。程式無法量測 J1 電壓、電流或電容 C1/C5 是否正常，也無法代替萬用電表、示波器及實體組裝檢查。沒有 Plate 時，不能測 Plate 的 Q17、IR LED 與光電晶體。
