Hemlock-white/Babot_revisioned_Mechatronics_TermProject/history/README.md

# Earlier versions and notes

`PCB/` contains the first through-hole Base conversion, the incomplete two-layer Base draft and routing trials, and a compact archive of KiCad's pre-reorganization local snapshots. The original source downloads are in `original/`, not here.

`notes/` retains the previous Base and Plate circuit-learning drafts for reference. New teaching documents in `docs/` are intentionally deferred.
