Hemlock-white/Babot_revisioned_Mechatronics_TermProject/history/PCB/plate_invalid_gerbers/README.md

# Rejected Plate fabrication export

The original submitted [`plate_THT_2layers_Gerbers.zip`](plate_THT_2layers_Gerbers.zip) and its unpacked files under `plate/` are retained for provenance. Both solder-mask plots have no pad-opening graphics, and the ZIP lacks drill files. **Do not fabricate from this archive.** Use the corrected [`PCB/fabrication/plate_tht/`](../../../PCB/fabrication/plate_tht/) package instead.
