Hemlock-white/Babot_revisioned_Mechatronics_TermProject/history/PCB/plate_unrouted_draft/README.md

# Earlier Plate placement

This is the older, unrouted two-layer Plate PCB that was replaced by the routed and mask-corrected [`PCB/KiCad/BaBot_Plate_THT.kicad_pcb`](../../../PCB/KiCad/BaBot_Plate_THT.kicad_pcb). It is kept as a development snapshot and has no fabrication output.
