Hemlock-white/Babot_revisioned_Mechatronics_TermProject/original/schematics/schematics_iNWgbALrz5.pdf

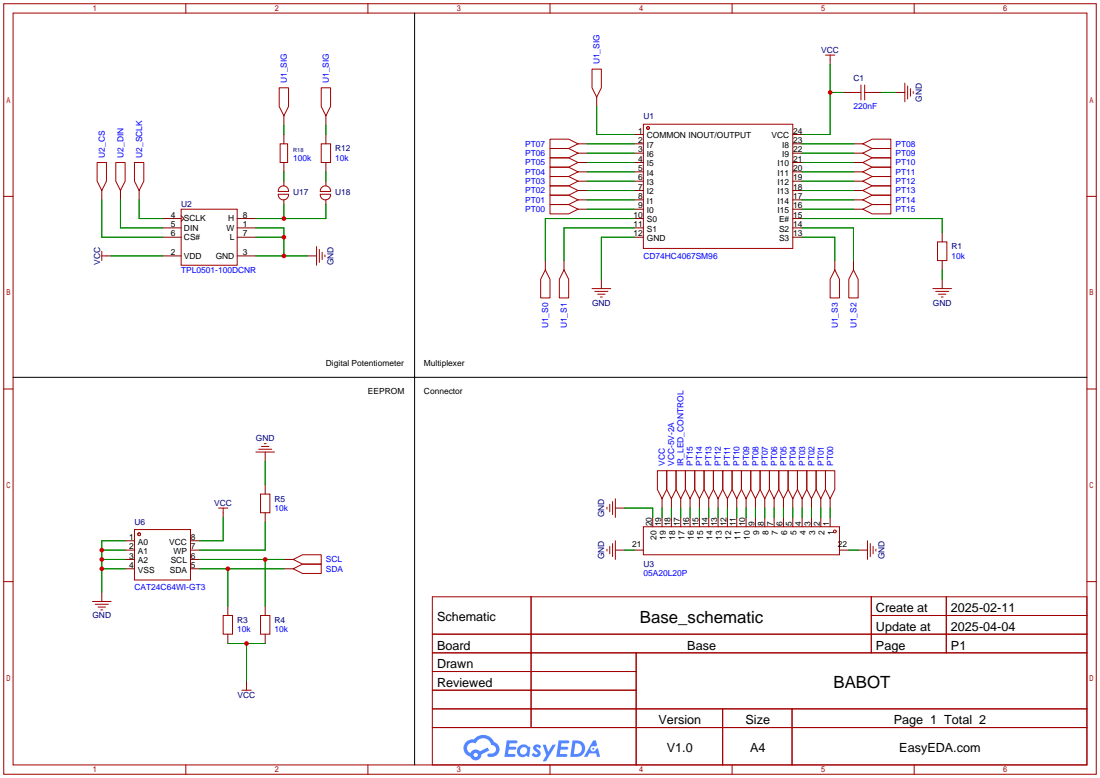
[picture p80: page 1]

GND
05A20L20P VCC VCC⁻⁵V⁻²A IR_LED_CONTROL PT15

Schematic | Base_schematic | Create at | 2025-02-11

Update at | 2025-04-04

Board | Base | Page | P1
Drawn | | BABOT
Reviewed

Version | Size | Page 1 Total 2
V1.0 | A4 | EasyEDA.com

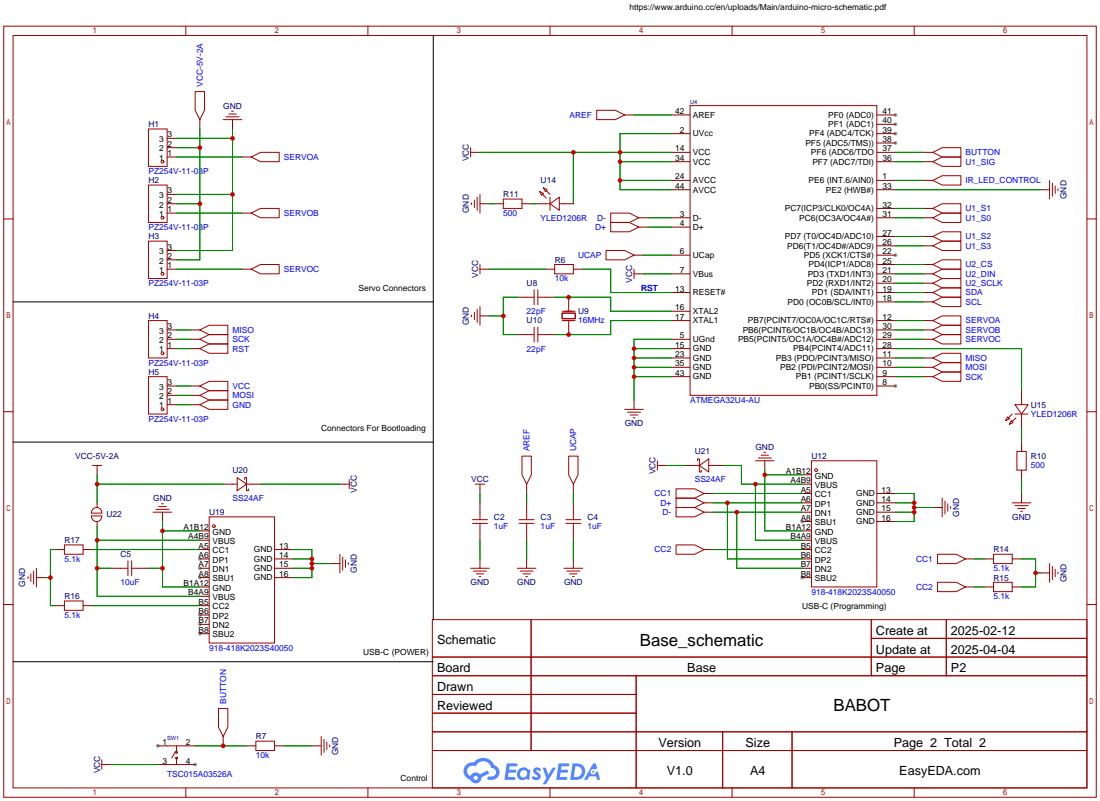
[picture p81: page 2]

https://www.arduino.cc/en/uploads/Main/arduino-micro-schematic.pdf VCC

PB7(PCINT7/OC0A/OC1C/RTS#) 12
PB2 (PDI/PCINT2/MOSI) 10 PB3 (PDO/PCINT3/MISO) 11 PB4(PCINT4/ADC11) 28 PB5(PCINT5/OC1A/OC4B#/ADC12) 29 PB6(PCINT6/OC1B/OC4B/ADC13) 30

Connectors For Bootloading
SBU2 B8 DN2 B7 DP2 B6 CC2 B5 VBUS B4A9 GND B1A12 SBU1 A8 DN1 A7 DP1 A6 CC1 A5 VBUS A4B9 GND A1B12

GND 16 GND 15 GND 14 GND 13

Schematic | Base_schematic | Create at | 2025-02-12

Update at | 2025-04-04

Board | Base | Page | P2
Drawn | | BABOT
Reviewed

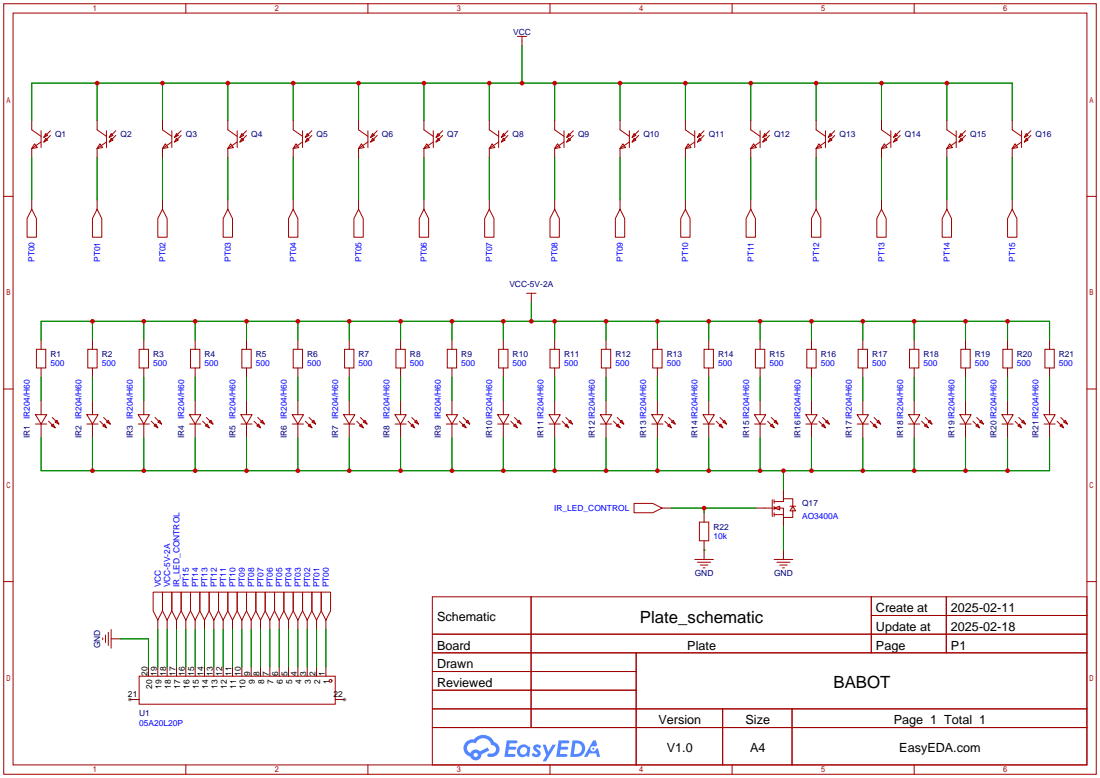
[picture p82: page 3]

05A20L20P VCC VCC⁻⁵V⁻²A IR_LED_CONTROL PT15

Schematic | Plate_schematic | Create at | 2025-02-11

Update at | 2025-02-18

Board | Plate | Page | P1
Drawn | | BABOT
Reviewed
