Hemlock-white/Babot_revisioned_Mechatronics_TermProject/history/PCB/base_2layer_draft/BaBot_Base_THT_4067_Module_2Layer_DRAFT.kicad_pcb

## KiCad design history/PCB/base_2layer_draft/BaBot_Base_THT_4067_Module_2Layer_DRAFT.kicad_pcb (2026-10-10)

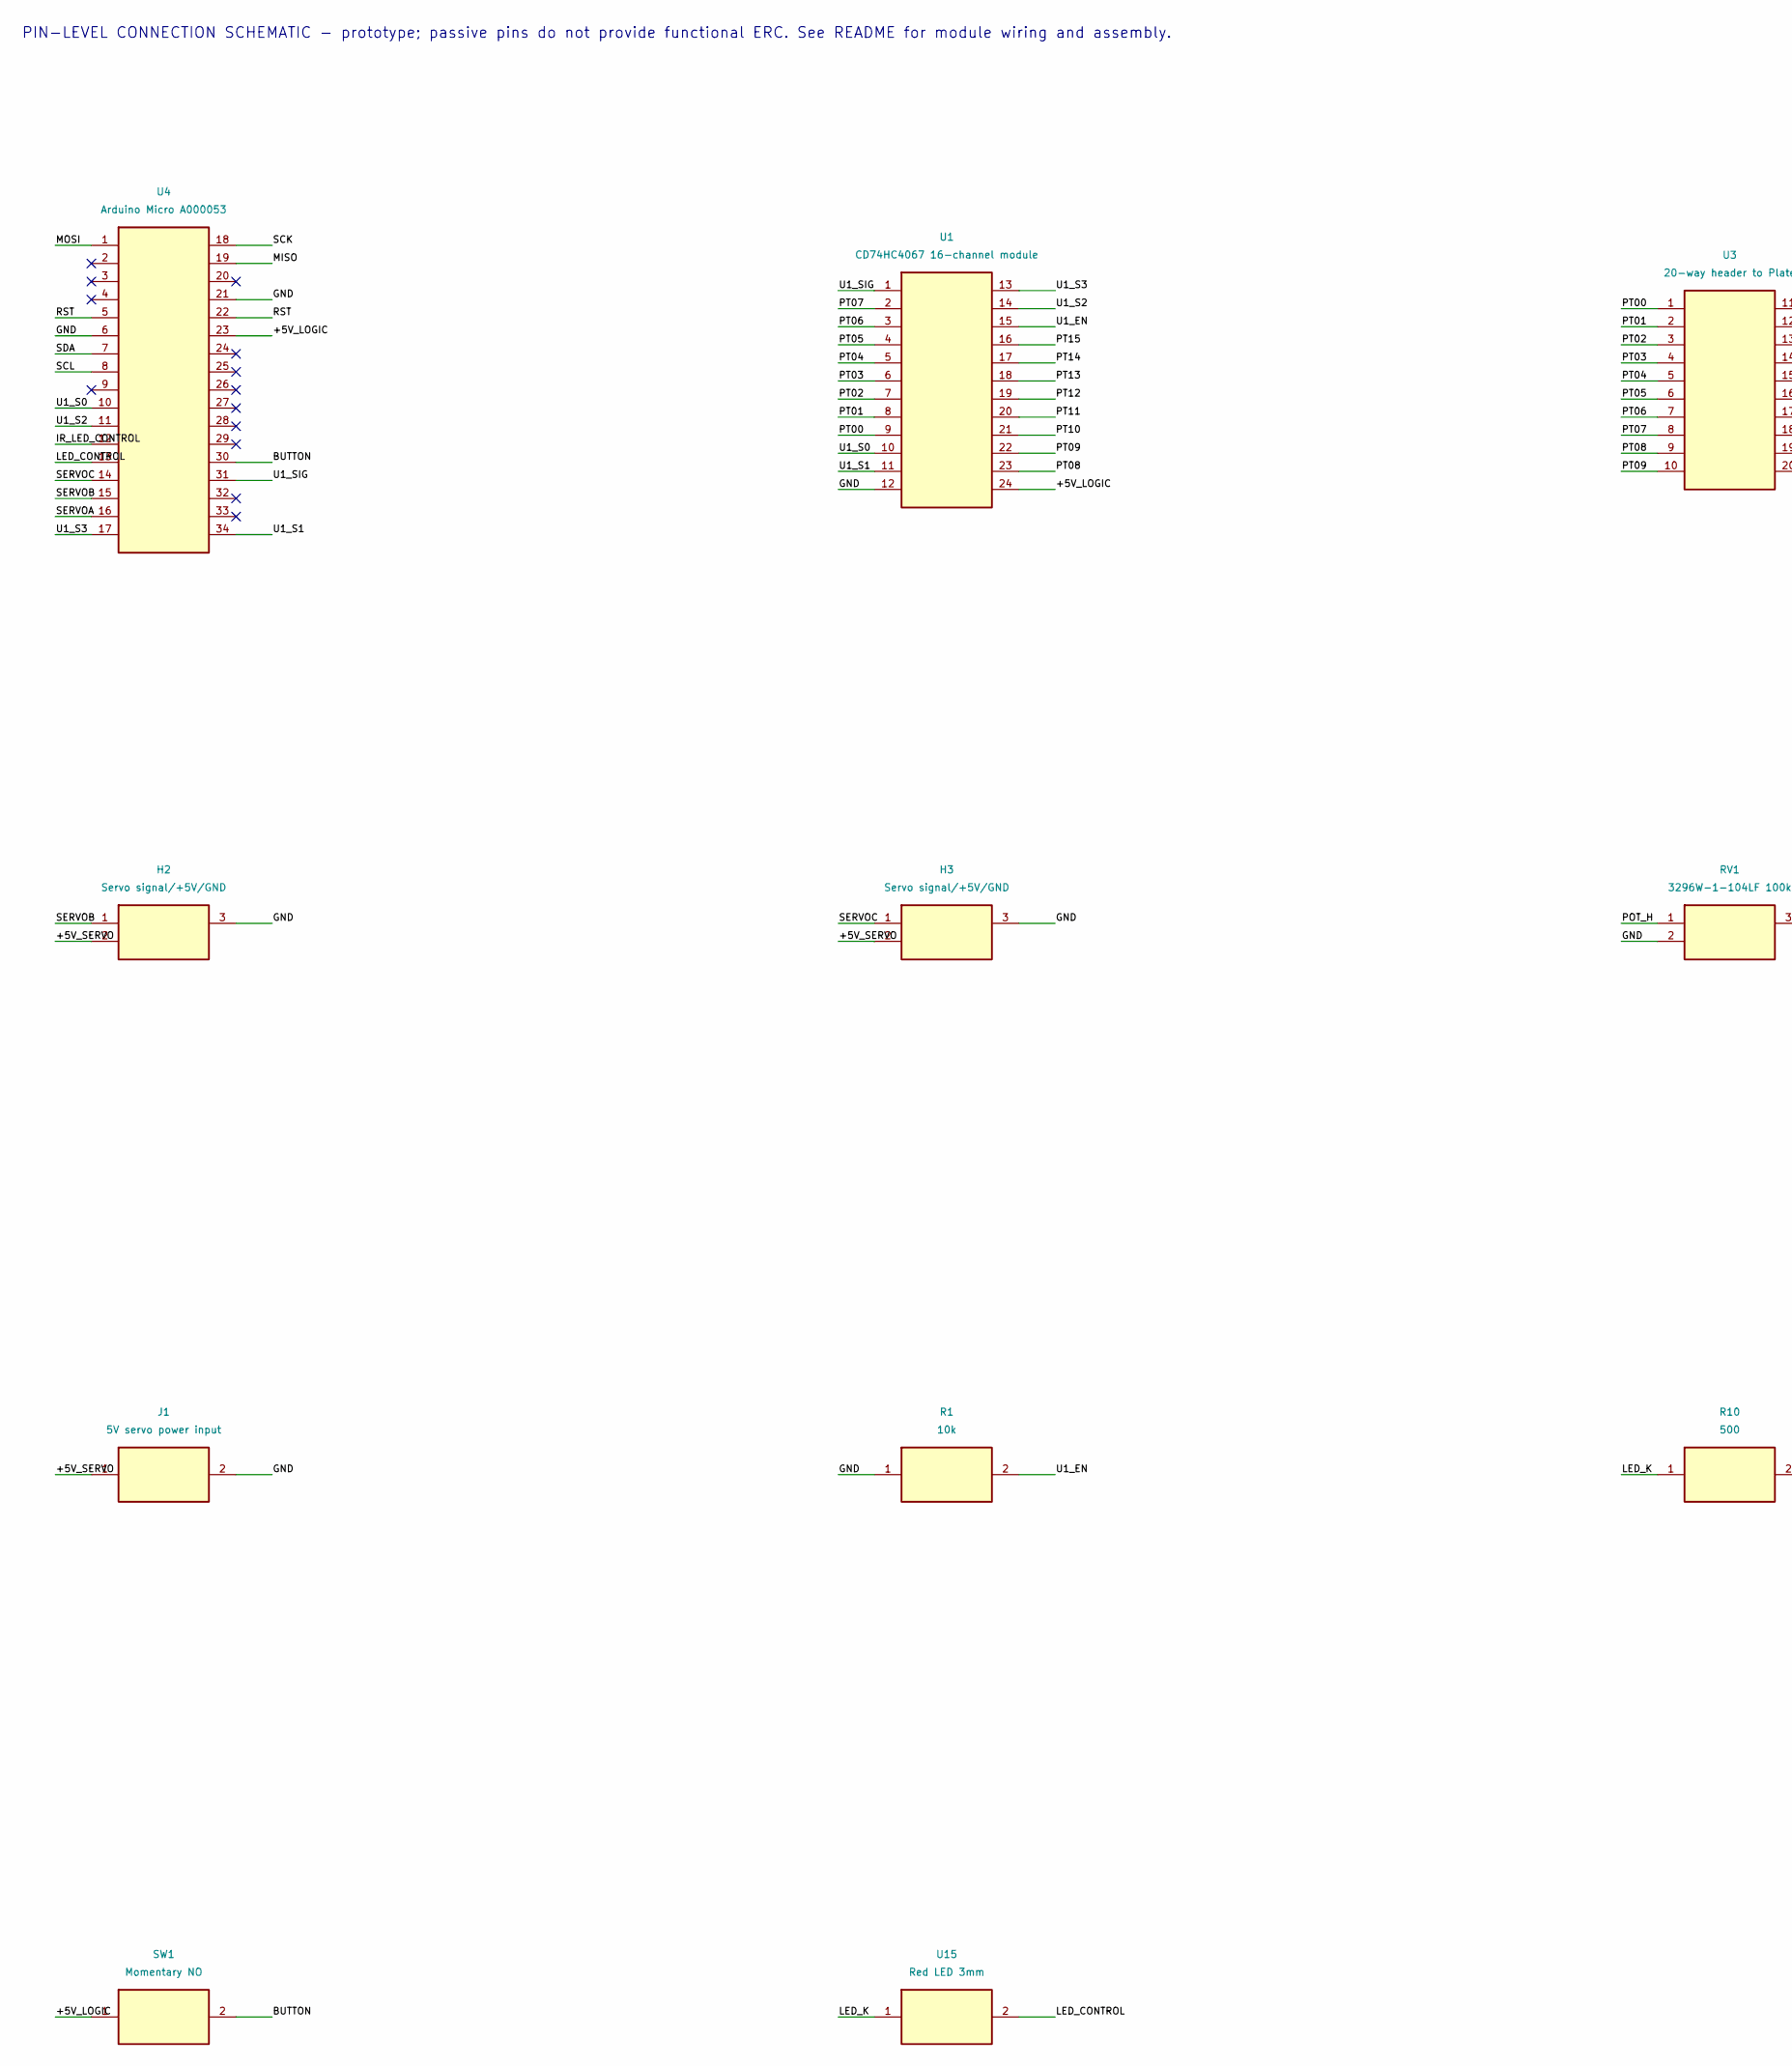
[picture p83: schematic BaBot_Base_THT_4067_Module_2Layer_DRAFT.kicad_sch, BaBot Base THT carrier, part in row 1, column 1]

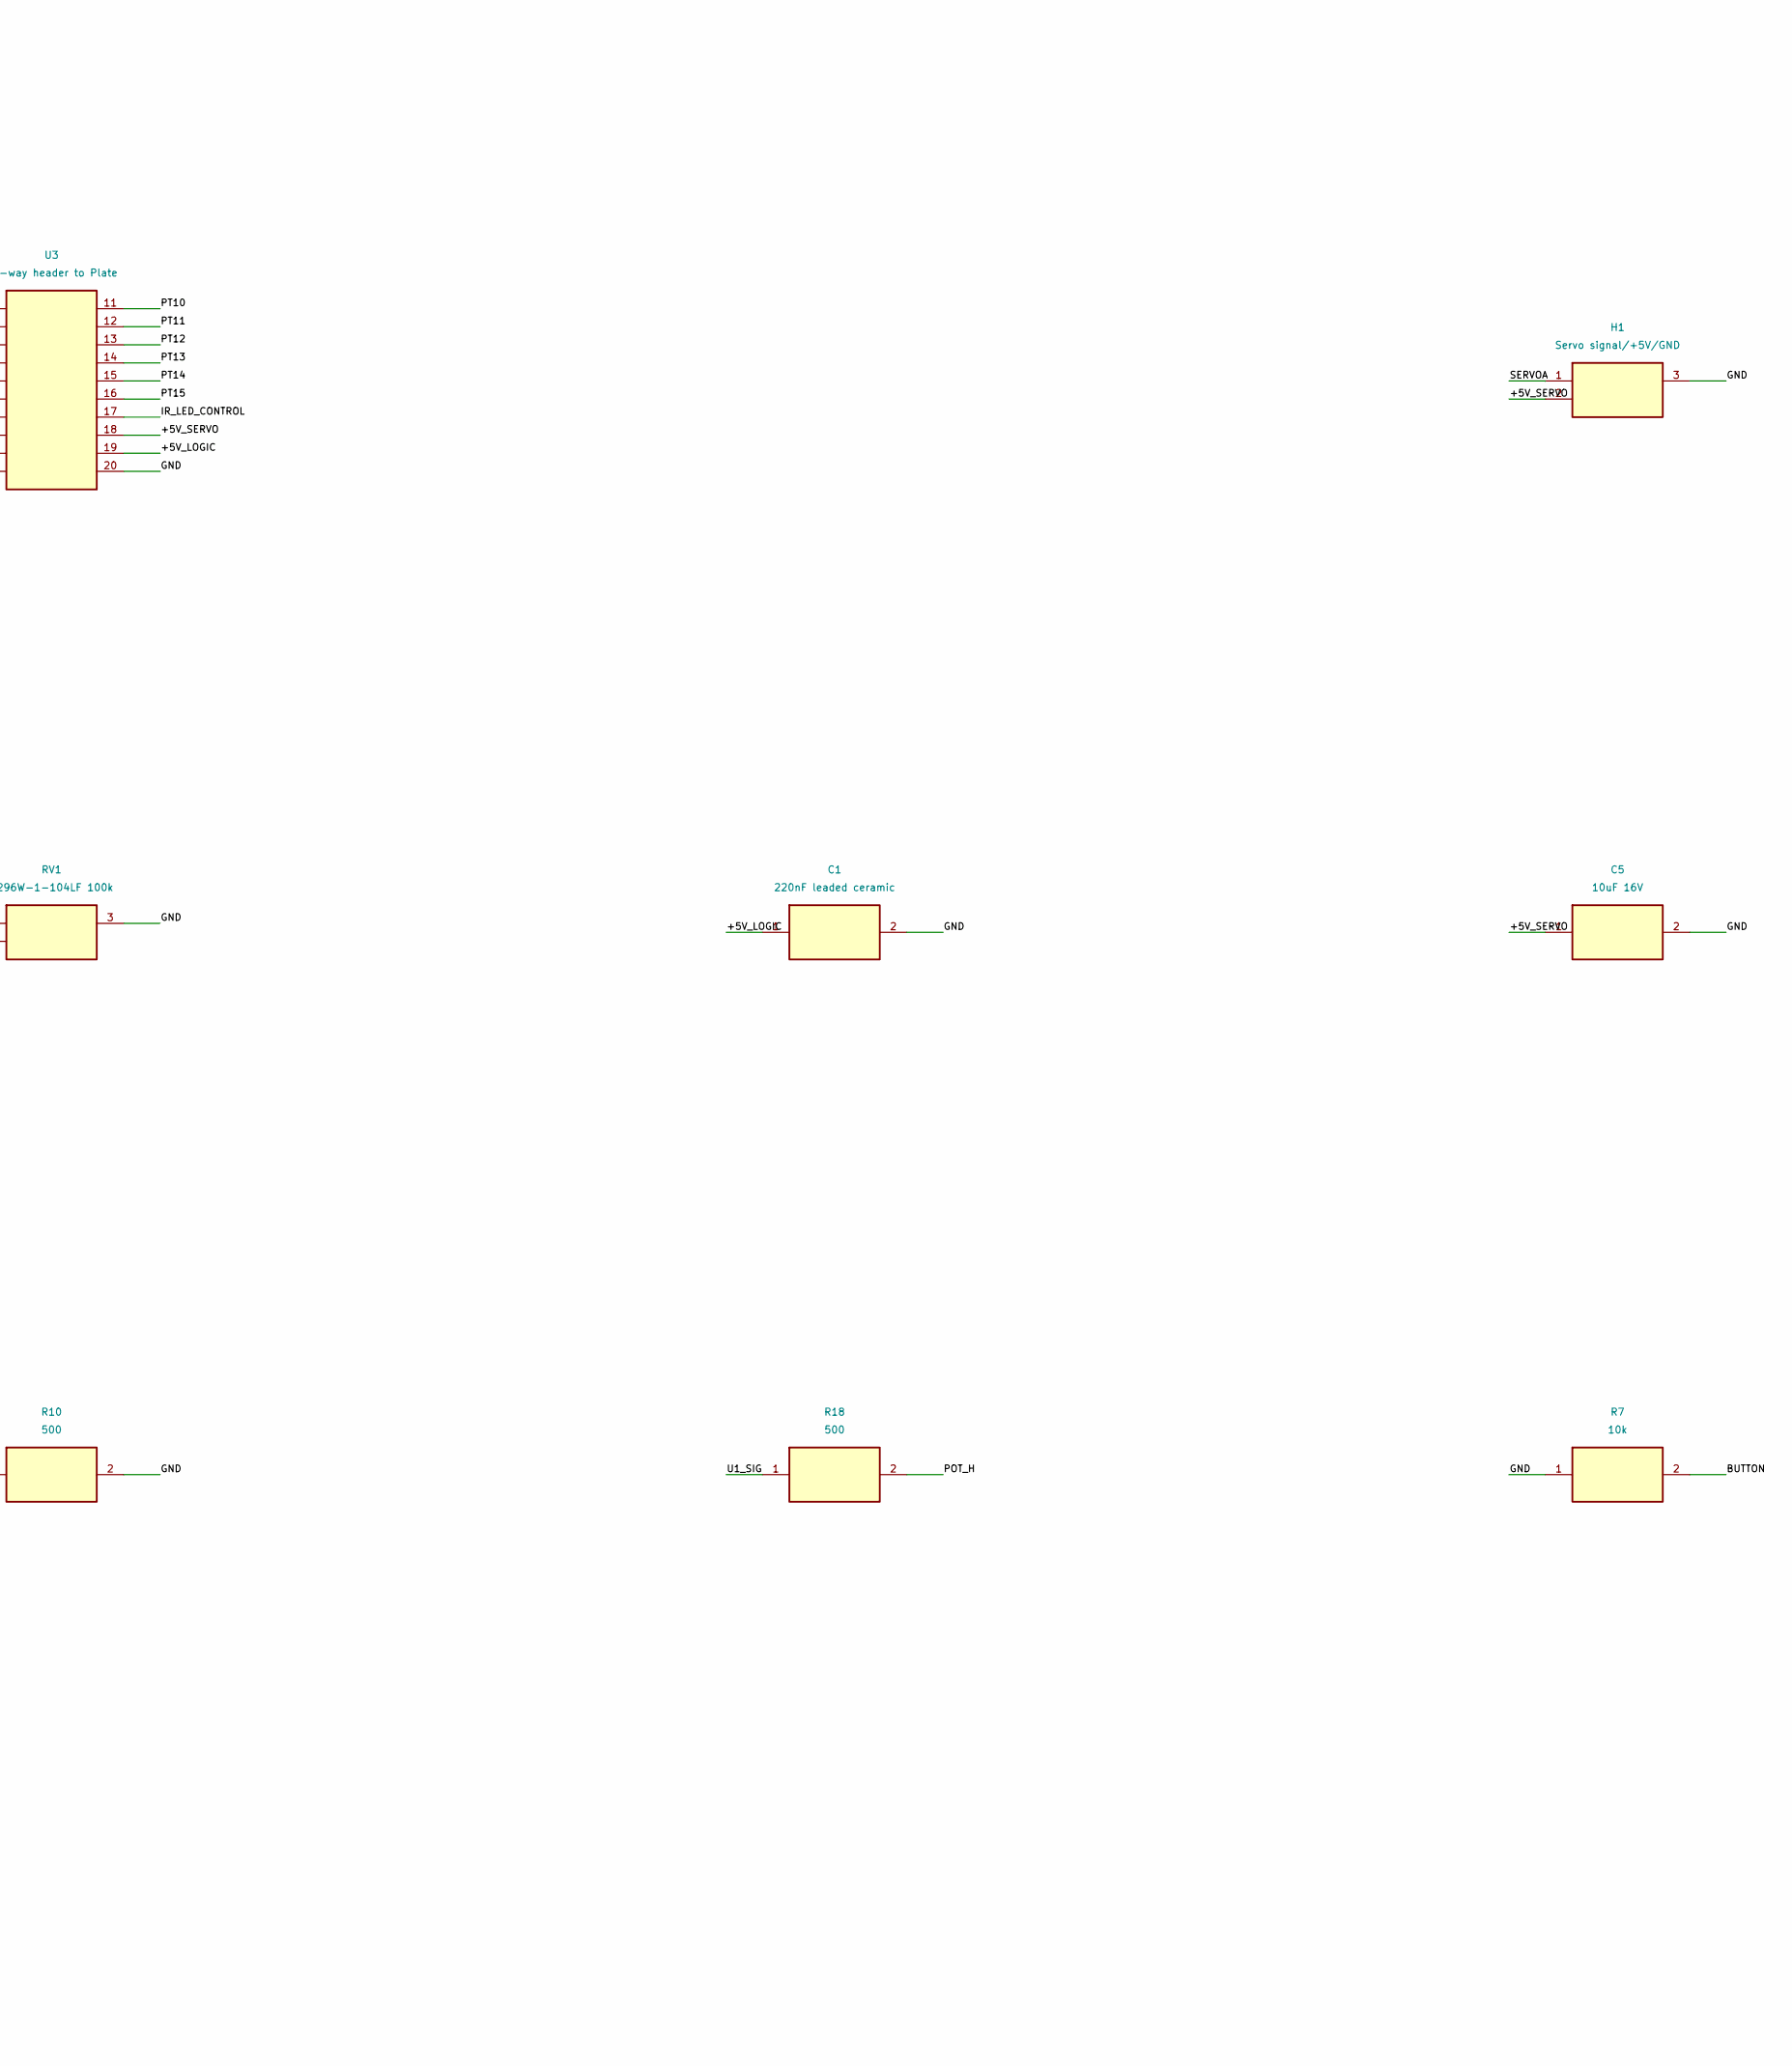
[picture p84: schematic BaBot_Base_THT_4067_Module_2Layer_DRAFT.kicad_sch, BaBot Base THT carrier, part in row 1, column 2]

Parts:
C1: 220nF leaded ceramic; Ceramic_5mm
C5: 10uF 16V; Electrolytic_5mm
H1: Servo signal/+5V/GND; Original_Base_H1
H2: Servo signal/+5V/GND; Original_Base_H2
H3: Servo signal/+5V/GND; Original_Base_H3
J1: 5V servo power input; Power_Terminal
R1, R7: 10k; Axial_R_10.16
R10, R18: 500; Axial_R_10.16
RV1: 3296W-1-104LF 100k; Potentiometer_Bourns_3296W_Vertical
SW1: Momentary NO; Pushbutton_6mm
U1: CD74HC4067 16-channel module; CD74HC4067_Module_2Layer
U3: 20-way header to Plate; Header20
U4: Arduino Micro A000053; Arduino_Micro_A000053
U15: Red LED 3mm; LED_3mm

Connections:
+5V_LOGIC: C1.1, SW1.1, U1.24, U3.19, U4.23
+5V_SERVO: C5.1, H1.2, H2.2, H3.2, J1.1, U3.18
BUTTON: R7.2, SW1.2, U4.30
GND: C1.2, C5.2, H1.3, H2.3, H3.3, J1.2, R1.1, R7.1, R10.2, RV1.2, RV1.3, U1.12, U3.20, U4.6, U4.21
IR_LED_CONTROL: U3.17, U4.12
LED_CONTROL: U4.13, U15.2
LED_K: R10.1, U15.1
MISO: U4.19
MOSI: U4.1
POT_H: R18.2, RV1.1
PT00: U1.9, U3.1
PT01: U1.8, U3.2
PT02: U1.7, U3.3
PT03: U1.6, U3.4
PT04: U1.5, U3.5
PT05: U1.4, U3.6
PT06: U1.3, U3.7
PT07: U1.2, U3.8
PT08: U1.23, U3.9
PT09: U1.22, U3.10
PT10: U1.21, U3.11
PT11: U1.20, U3.12
PT12: U1.19, U3.13
PT13: U1.18, U3.14
PT14: U1.17, U3.15
PT15: U1.16, U3.16
RST: U4.5, U4.22
SCK: U4.18
SCL: U4.8
SDA: U4.7
SERVOA: H1.1, U4.16
SERVOB: H2.1, U4.15
SERVOC: H3.1, U4.14
U1_EN: R1.2, U1.15
U1_S0: U1.10, U4.10
U1_S1: U1.11, U4.34
U1_S2: U1.14, U4.11
U1_S3: U1.13, U4.17
U1_SIG: R18.1, U1.1, U4.31

Notes on the sheet:
PIN-LEVEL CONNECTION SCHEMATIC - prototype; passive pins do not provide functional ERC. See README for module wiring and assembly.

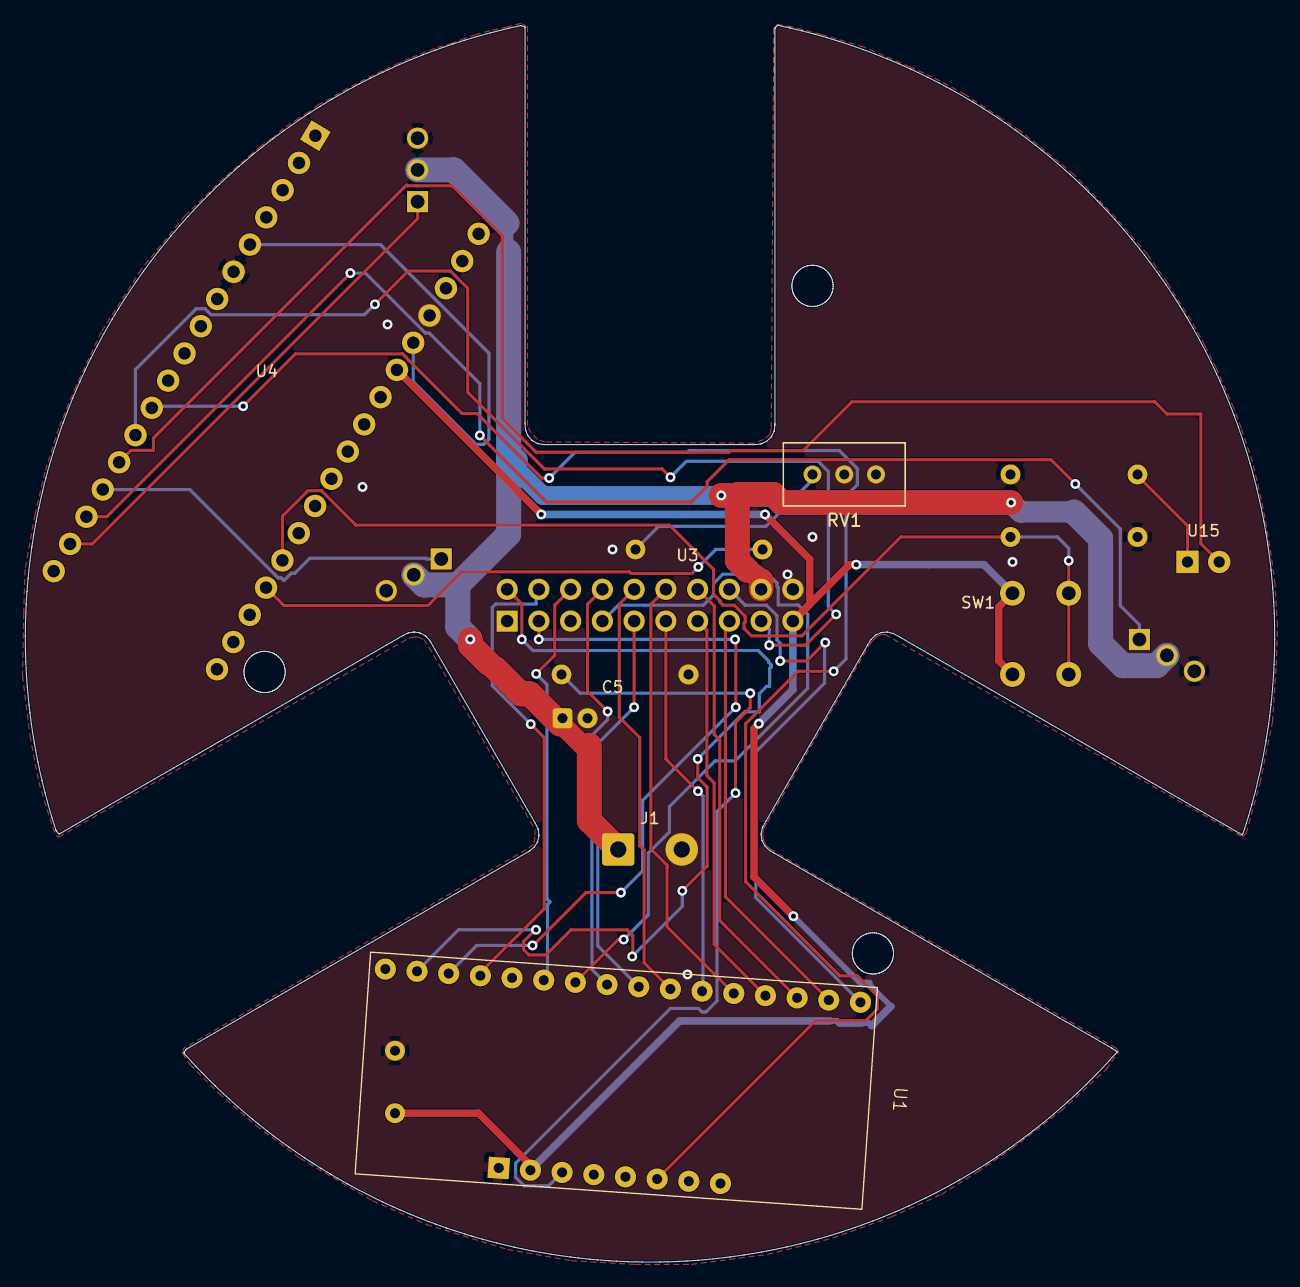
[picture p85: board BaBot_Base_THT_4067_Module_2Layer_DRAFT.kicad_pcb from above]

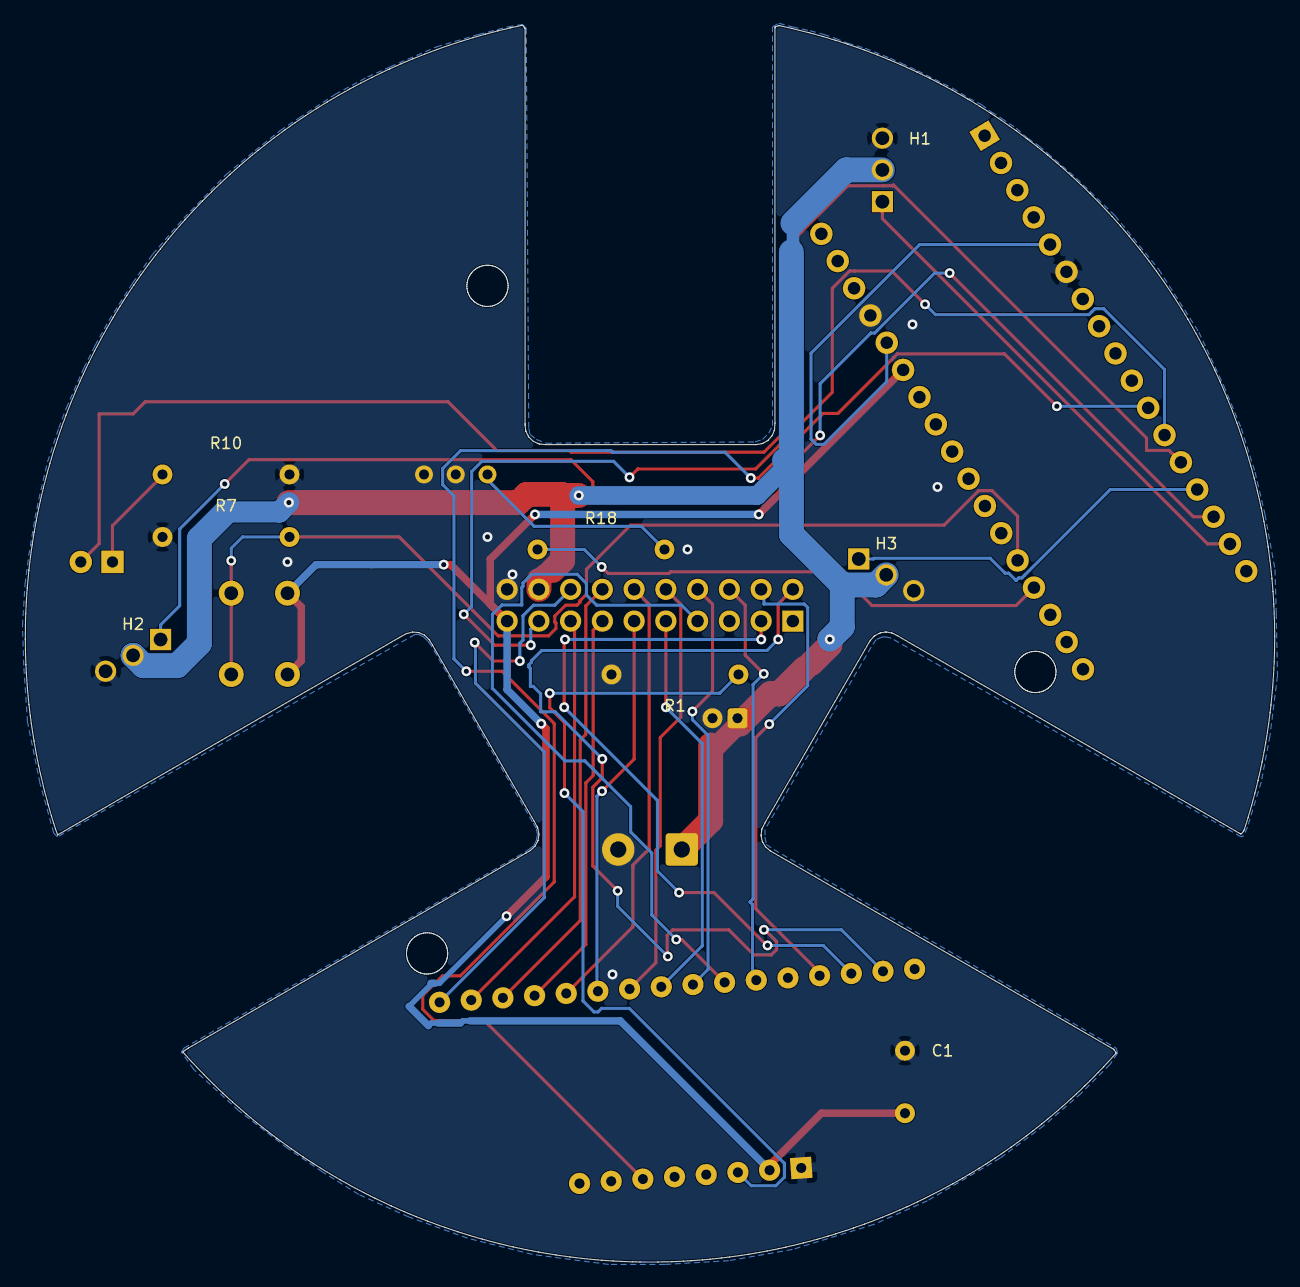
[picture p86: board BaBot_Base_THT_4067_Module_2Layer_DRAFT.kicad_pcb from below]

Board: 2 copper layers, 99.9 x 98.9 mm, 16 parts (8 on the bottom side), 34 nets.
