Hemlock-white/Babot_revisioned_Mechatronics_TermProject/PCB/KiCad/BaBot_Plate_THT.kicad_pcb

## KiCad design PCB/KiCad/BaBot_Plate_THT.kicad_pcb (2026-10-23)

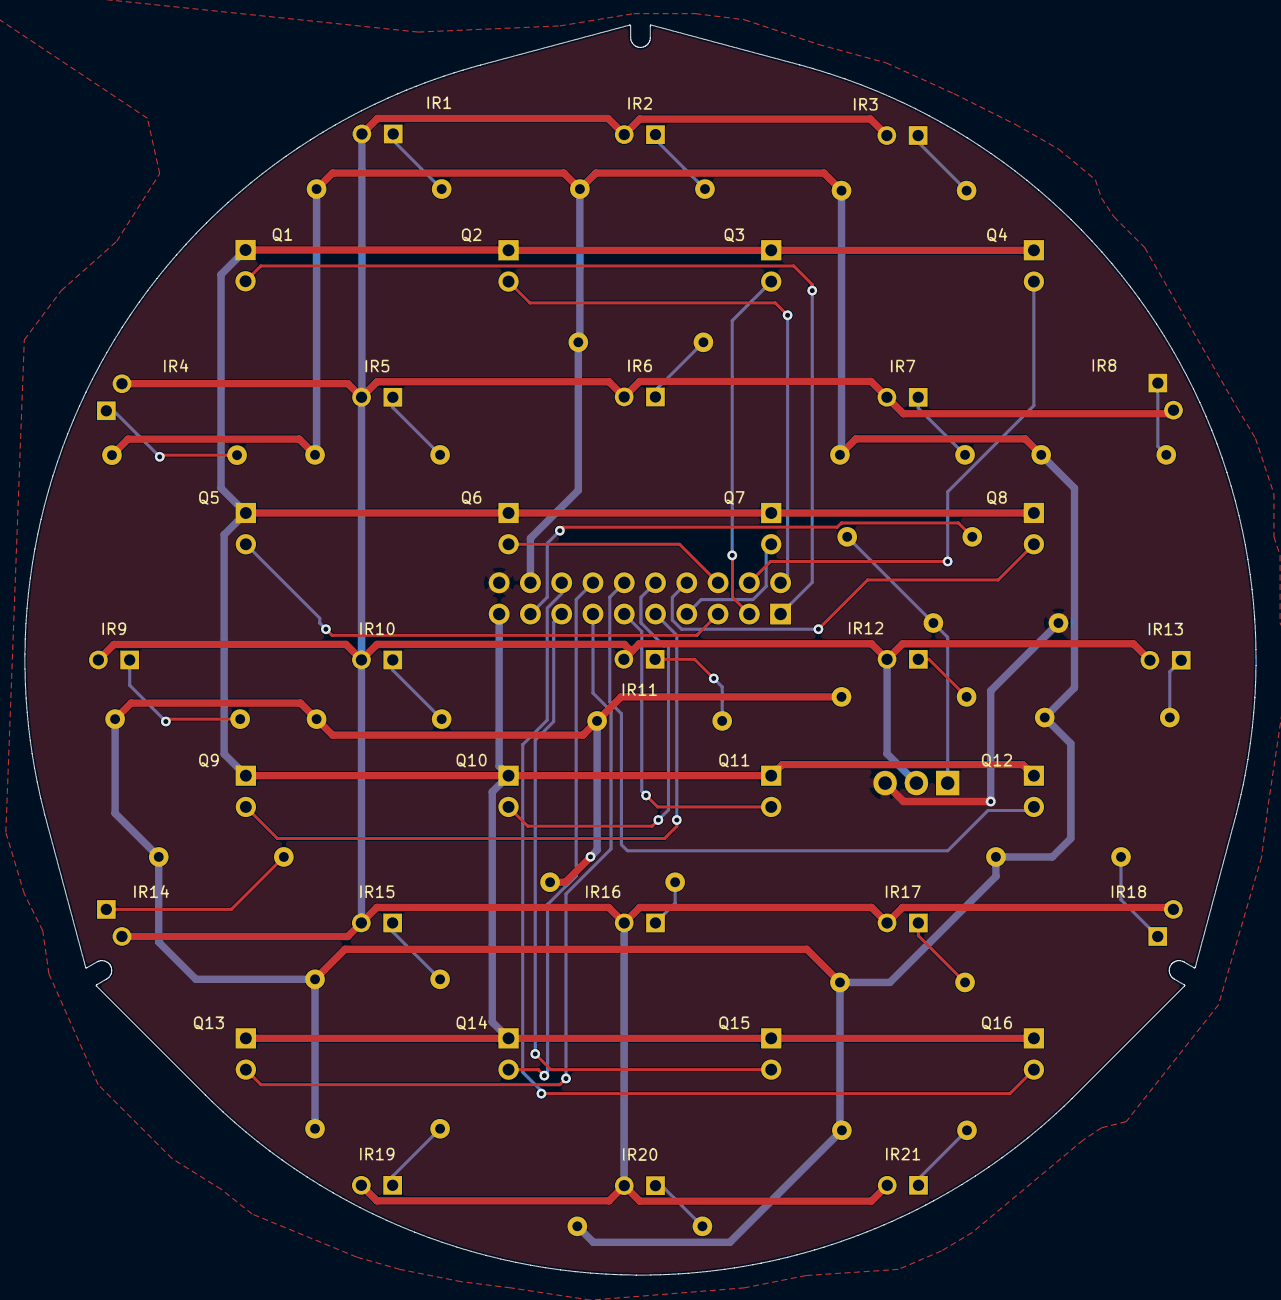
[picture p87: board BaBot_Plate_THT.kicad_pcb from above]

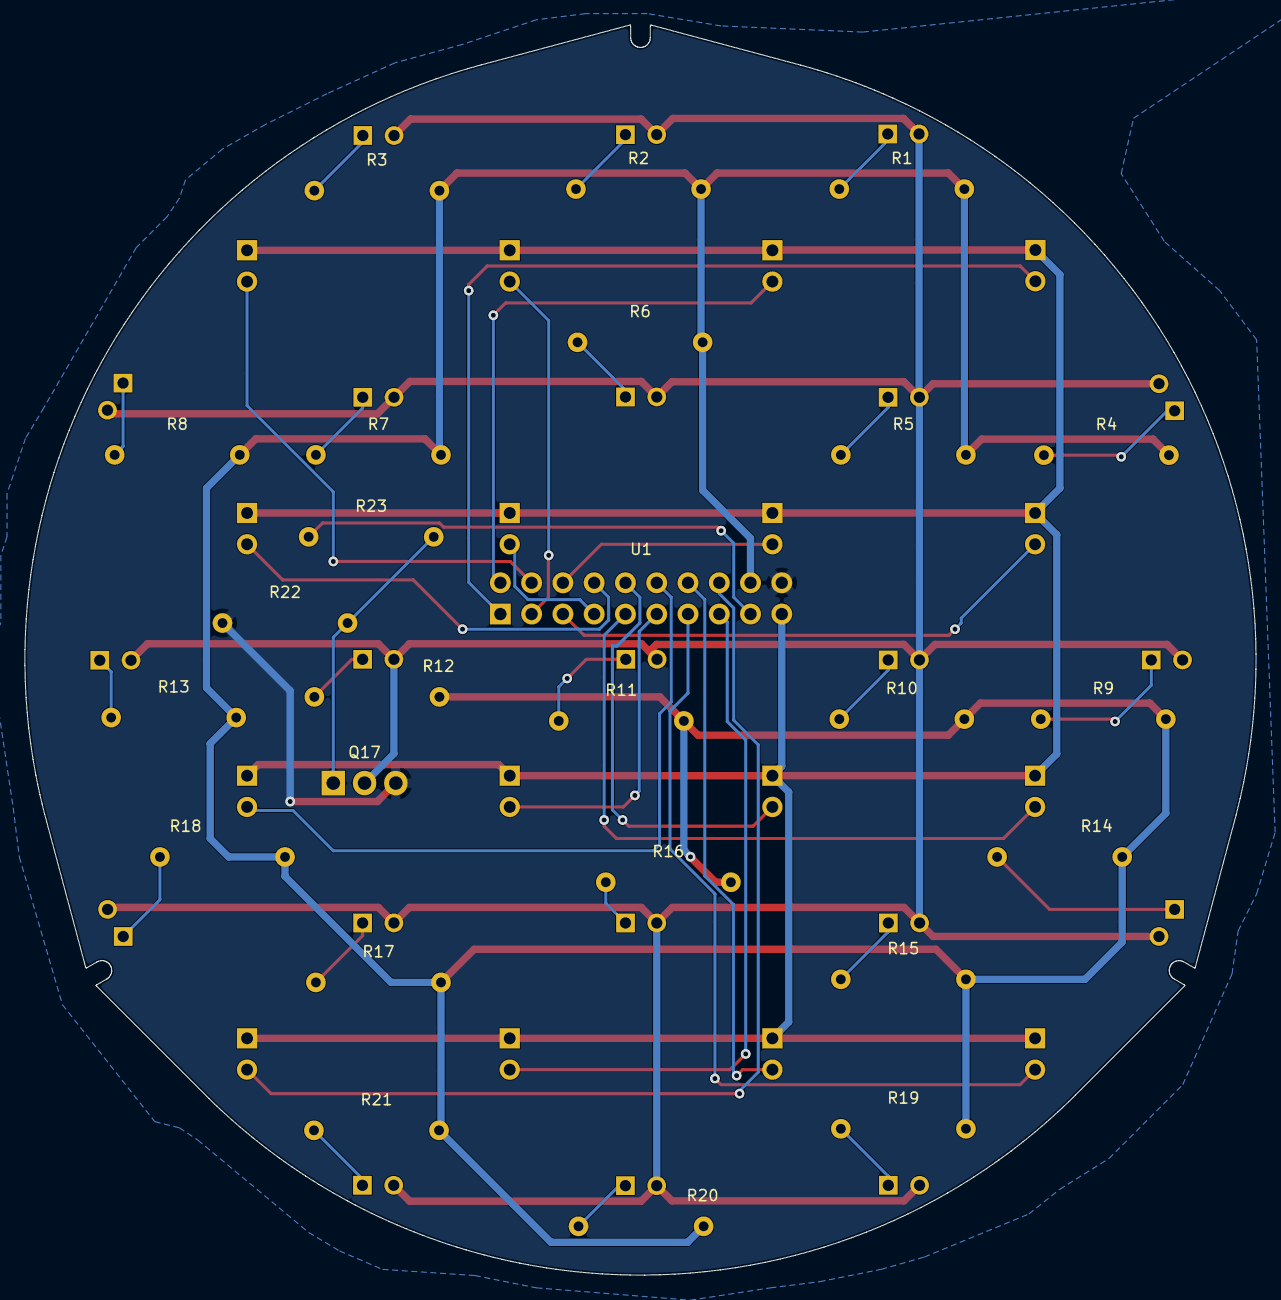
[picture p88: board BaBot_Plate_THT.kicad_pcb from below]

Board: 2 copper layers, 100.0 x 101.5 mm, 62 parts (25 on the bottom side), 43 nets.

Parts:
IR1: IR204/H60; Original_Plate_IR1
IR2: IR204/H60; Original_Plate_IR2
IR3: IR204/H60; Original_Plate_IR3
IR4: IR204/H60; Original_Plate_IR4
IR5: IR204/H60; Original_Plate_IR5
IR6: IR204/H60; Original_Plate_IR6
IR7: IR204/H60; Original_Plate_IR7
IR8: IR204/H60; Original_Plate_IR8
IR9: IR204/H60; Original_Plate_IR9
IR10: IR204/H60; Original_Plate_IR10
IR11: IR204/H60; Original_Plate_IR11
IR12: IR204/H60; Original_Plate_IR12
IR13: IR204/H60; Original_Plate_IR13
IR14: IR204/H60; Original_Plate_IR14
IR15: IR204/H60; Original_Plate_IR15
IR16: IR204/H60; Original_Plate_IR16
IR17: IR204/H60; Original_Plate_IR17
IR18: IR204/H60; Original_Plate_IR18
IR19: IR204/H60; Original_Plate_IR19
IR20: IR204/H60; Original_Plate_IR20
IR21: IR204/H60; Original_Plate_IR21
Q1: 1540031NC6090; Original_Plate_Q1
Q2: 1540031NC6090; Original_Plate_Q2
Q3: 1540031NC6090; Original_Plate_Q3
Q4: 1540031NC6090; Original_Plate_Q4
Q5: 1540031NC6090; Original_Plate_Q5
Q6: 1540031NC6090; Original_Plate_Q6
Q7: 1540031NC6090; Original_Plate_Q7
Q8: 1540031NC6090; Original_Plate_Q8
Q9: 1540031NC6090; Original_Plate_Q9
Q10: 1540031NC6090; Original_Plate_Q10
Q11: 1540031NC6090; Original_Plate_Q11
Q12: 1540031NC6090; Original_Plate_Q12
Q13: 1540031NC6090; Original_Plate_Q13
Q14: 1540031NC6090; Original_Plate_Q14
Q15: 1540031NC6090; Original_Plate_Q15
Q16: 1540031NC6090; Original_Plate_Q16
Q17: FQP30N06L; TO220_GDS
R1, R2, R3, R4, R5, R6, R7, R8, R9, R10, R11, R12, R13, R14, R15, R16, R17, R18, R19, R20, R21: 330; Axial_R_10.16
R22: 10k; Axial_R_10.16
R23: 220; Axial_R_10.16
U1: 20-way header to Base; Header20

Connections:
$1N2899: IR1.1, R1.1
$1N5933: IR2.1, R2.1
$1N6007: IR3.1, R3.1
$1N6081: IR4.1, R4.1
$1N6155: IR5.1, R5.1
$1N6229: IR6.1, R6.1
$1N6303: IR7.1, R7.1
$1N6377: IR8.1, R8.1
$1N6451: IR9.1, R9.1
$1N6525: IR10.1, R10.1
$1N6599: IR11.1, R11.1
$1N6673: IR12.1, R12.1
$1N6747: IR13.1, R13.1
$1N6821: IR14.1, R14.1
$1N6895: IR15.1, R15.1
$1N6969: IR16.1, R16.1
$1N7043: IR17.1, R17.1
$1N7117: IR18.1, R18.1
$1N7191: IR19.1, R19.1
$1N7265: IR20.1, R20.1
$1N7339: IR21.1, R21.1
+5V_LOGIC: Q1.1, Q2.1, Q3.1, Q4.1, Q5.1, Q6.1, Q7.1, Q8.1, Q9.1, Q10.1, Q11.1, Q12.1, Q13.1, Q14.1, Q15.1, Q16.1, U1.19
+5V_SERVO: R1.2, R2.2, R3.2, R4.2, R5.2, R6.2, R7.2, R8.2, R9.2, R10.2, R11.2, R12.2, R13.2, R14.2, R15.2, R16.2, R17.2, R18.2, R19.2, R20.2, R21.2, U1.18
GND: Q17.3, R22.1, U1.20
IR_CATHODES: IR1.2, IR2.2, IR3.2, IR4.2, IR5.2, IR6.2, IR7.2, IR8.2, IR9.2, IR10.2, IR11.2, IR12.2, IR13.2, IR14.2, IR15.2, IR16.2, IR17.2, IR18.2, IR19.2, IR20.2, IR21.2, Q17.2
IR_LED_CONTROL: R23.1, U1.17
MOSFET_GATE: Q17.1, R22.2, R23.2
PT00: Q1.2, U1.1
PT01: Q2.2, U1.2
PT02: Q3.2, U1.3
PT03: Q4.2, U1.4
PT04: Q5.2, U1.5
PT05: Q6.2, U1.6
PT06: Q7.2, U1.7
PT07: Q8.2, U1.8
PT08: Q9.2, U1.9
PT09: Q10.2, U1.10
PT10: Q11.2, U1.11
PT11: Q12.2, U1.12
PT12: Q13.2, U1.13
PT13: Q14.2, U1.14
PT14: Q15.2, U1.15
PT15: Q16.2, U1.16
