Hemlock-white/Babot_revisioned_Mechatronics_TermProject/software/main/main.ino

/**
 * BaBot Code
 * Temporary integrated test: Plate senses the ball and the three servos
 * respond through the original ON-mode controller. Button modes, assembly
 * sweep, and interactive servo calibration are disabled in loop().
 * Calibration offsets are fixed at the default 100 for this test.
 */

#include <CD74HC4067.h>
#include <Servo.h>
#include <math.h>
#include <EEPROM.h>

// ============================================================================
// CONFIGURATION CONSTANTS
// ============================================================================

float P_GAIN = 3.0;
float I_GAIN = 0.04;
float D_GAIN = 25.0;

const float DEG2RAD  = M_PI / 180.0;
const float RAD2DEG  = 180.0 / M_PI;
const float R1       = 50.0;
const float R2       = 39.2;
const float BASE_R   = 32.9  / sqrt(3.0);
const float PLAT_R   = 107.9 / sqrt(3.0);
const float PLATE_HEIGHT = 65.0;

const int BUTTON_PIN      = A1;
const int LED_PIN         = 8;
const int IR_LED_PIN      = 7;
const int IR_RECEIVER_PIN = A0;
const int SERVO_PIN_A     = 11;
const int SERVO_PIN_B     = 10;
const int SERVO_PIN_C     = 9;

const float IR_SMOOTH_ALPHA     = 0.7;
const float OUTPUT_SMOOTH_ALPHA = 0.9;
const float BALL_THRESHOLD      = 200.0;  // Trial value; compare empty/ball readings before final tuning.
const float VEL_SCALE           = 0.001;

const unsigned long DOUBLE_PRESS_GAP = 500;
const unsigned long LONG_PRESS_TIME  = 1000;

const int EEPROM_ADDR_A = 0;
const int EEPROM_ADDR_B = 4;
const int EEPROM_ADDR_C = 8;

// ============================================================================
// TYPE DEFINITIONS
// ============================================================================

enum BaBotMode   { ON, OFF, ASSEMBLY, CALIBRATION };
enum CalibServo  { CALIB_A, CALIB_B, CALIB_C, CALIB_DONE };
enum ButtonPress { NO_PRESS, SINGLE_PRESS, DOUBLE_PRESS, TRIPLE_PRESS, QUAD_PRESS, LONG_PRESS };

// ============================================================================
// GLOBAL STATE
// ============================================================================

int   ambientLight[16] = {0};
int   irLight[16]      = {0};
float irSignal[16]     = {0.0};
float irSignalRaw[16]  = {0.0};

float centerX = 0.0, centerY = 0.0;
float setpointX = 0.0, setpointY = 0.0;

float lastErrorX = 0.0, lastErrorY = 0.0;
float integralX  = 0.0, integralY  = 0.0;

float plateRoll  = 0.0, platePitch  = 0.0;
float smoothRoll = 0.0, smoothPitch = 0.0;

bool          ballWasOnPlate = false;
unsigned long ballLostTime   = 0;

BaBotMode  mode       = ON;
CalibServo calibServo = CALIB_A;

int servoOffsetA = 100;
int servoOffsetB = 100;
int servoOffsetC = 100;

unsigned long buttonDownTime = 0;
unsigned long lastPressTime  = 0;
int           pressCount     = 0;

// Latched press: ensures button presses are never lost between fast and 30Hz paths
ButtonPress lastPress = NO_PRESS;

int skipCounter = 0;

CD74HC4067 mux(5, 13, 6, 12);
Servo servoA, servoB, servoC;

unsigned long testStartTime = 0;

uint8_t assemblyStep = 0;  // 0=IDLE, 1=SWEEP_A, 2=SWEEP_B, 3=SWEEP_C
int     assemblyPos  = 0;

// ============================================================================
// TIMING HELPER
// ============================================================================

/**
 * Returns true at most once per 33333us (30Hz)
 */
bool every30Hz() {
  static unsigned long last = 0;
  unsigned long now = micros();
  if (now - last < 33333) return false;
  last = now;
  return true;
}

// ============================================================================
// SETUP
// ============================================================================

void printBallTestStatus();

void setup() {
  // pinMode(BUTTON_PIN, INPUT);  // No button/mode changes in this temporary test.
  pinMode(LED_PIN,         OUTPUT);
  pinMode(IR_LED_PIN,      OUTPUT);

  servoA.attach(SERVO_PIN_A);
  servoB.attach(SERVO_PIN_B);
  servoC.attach(SERVO_PIN_C);

  // EEPROM calibration is intentionally bypassed for this test. The global
  // servoOffsetA/B/C defaults (100) apply, independent of old EEPROM data.
  // EEPROM.get(EEPROM_ADDR_A, servoOffsetA);
  // EEPROM.get(EEPROM_ADDR_B, servoOffsetB);
  // EEPROM.get(EEPROM_ADDR_C, servoOffsetC);
  // servoOffsetA = constrain(servoOffsetA, 50, 150);
  // servoOffsetB = constrain(servoOffsetB, 50, 150);
  // servoOffsetC = constrain(servoOffsetC, 50, 150);

  Serial.begin(115200);
  ADCSRA = (ADCSRA & 0b11111000) | 0b101;  // ADC prescaler = 32 (faster)

  movePlatform(0, 0, PLATE_HEIGHT);
  delay(1000);
}

// ============================================================================
// MAIN LOOP
// ============================================================================

void loop() {
  // Temporary test: skip button, OFF, ASSEMBLY and CALIBRATION mode handling.
  // Keep the original 30 Hz Plate -> position -> PID -> servo path.
  if (!every30Hz()) return;

  measureIR();
  calculateWeightedCenter(irSignal, centerX, centerY);
  handleOnMode();
  digitalWrite(LED_PIN, ballOnPlate() ? HIGH : LOW);
  printBallTestStatus();
}

// Print at 5 Hz so the 30 Hz control loop is not flooded with serial text.
// The spread is calculated from the same smoothed values used by ballOnPlate().
void printBallTestStatus() {
  static unsigned long lastPrint = 0;
  if (millis() - lastPrint < 200 || !Serial) return;
  lastPrint = millis();

  float minV = irSignal[0], maxV = irSignal[0];
  for (int i = 1; i < 16; i++) {
    minV = min(minV, irSignal[i]);
    maxV = max(maxV, irSignal[i]);
  }
  Serial.print(ballOnPlate() ? "BALL" : "NO BALL");
  Serial.print("  spread="); Serial.print(maxV - minV, 1);
  Serial.print("/200  center=("); Serial.print(centerX, 2);
  Serial.print(","); Serial.print(centerY, 2);
  Serial.print(")  tilt=("); Serial.print(smoothRoll, 2);
  Serial.print(","); Serial.print(smoothPitch, 2);
  Serial.println(")");
}

// ============================================================================
// MODE HANDLERS
// ============================================================================

void handleOnMode() {
  if (ballOnPlate()) {
    digitalWrite(LED_PIN, HIGH);

    if (!ballWasOnPlate) {
      skipCounter = 2;
      lastErrorX = setpointX - centerX;
      lastErrorY = setpointY - centerY;
    }

    ballWasOnPlate = true;
    ballLostTime   = millis();

    if (skipCounter > 0) { skipCounter--; return; }

    pidControl(centerX, setpointX, lastErrorX, integralX, plateRoll);
    pidControl(centerY, setpointY, lastErrorY, integralY, platePitch);

    smoothRoll  = OUTPUT_SMOOTH_ALPHA * plateRoll  + (1 - OUTPUT_SMOOTH_ALPHA) * smoothRoll;
    smoothPitch = OUTPUT_SMOOTH_ALPHA * platePitch + (1 - OUTPUT_SMOOTH_ALPHA) * smoothPitch;

    movePlatform(smoothRoll, smoothPitch, PLATE_HEIGHT);

  } else {
    if (ballWasOnPlate && millis() - ballLostTime < 1000) {
      movePlatform(plateRoll, platePitch, PLATE_HEIGHT);
    } else {
      ballWasOnPlate = false;
      integralX = integralY = 0;
      lastErrorX = lastErrorY = 0;
      setpointX = setpointY = 0;
      plateRoll = platePitch = 0;
      movePlatform(0, 0, PLATE_HEIGHT);
    }
  }
}

void handleOffMode() {
  plateRoll = platePitch = 0;
  movePlatform(0, 0, PLATE_HEIGHT);
}

void handleAssemblyMode() {
  const int PARK_POS = 100;

  bool pressed = (lastPress == SINGLE_PRESS);
  if (pressed) lastPress = NO_PRESS;

  if (assemblyStep == 0 && pressed) {
    assemblyStep = 1;

    servoA.write(100);  
    servoA.write(180); delay(250);
    servoA.write(PARK_POS);

    servoB.write(100);   
    servoB.write(180); delay(250);
    servoB.write(PARK_POS);

    servoC.write(100);   
    servoC.write(180); delay(250);
    servoC.write(PARK_POS);

    assemblyStep = 0;  // back to IDLE, ready for next press
  }
}

// ============================================================================
// CALIBRATION
// ============================================================================

void runCalibration(ButtonPress press) {
  static CalibServo lastCalibServo = CALIB_DONE;

  // Init sequence when entering calibration fresh
  if (lastCalibServo == CALIB_DONE && calibServo == CALIB_A) {
    servoOffsetA = 100;
    servoOffsetB = 100;
    servoOffsetC = 100;
    moveServos(70, 70, 70);
    delay(2000);
  }
  lastCalibServo = calibServo;

  // Single press: increment current servo offset
  if (press == SINGLE_PRESS) {
    if (calibServo == CALIB_A) servoOffsetA++;
    if (calibServo == CALIB_B) servoOffsetB++;
    if (calibServo == CALIB_C) servoOffsetC++;
  }

  // Long press: advance to next servo
  if (press == LONG_PRESS) {
    if      (calibServo == CALIB_A) calibServo = CALIB_B;
    else if (calibServo == CALIB_B) calibServo = CALIB_C;
    else if (calibServo == CALIB_C) calibServo = CALIB_DONE;
  }

  // Calibration complete
  if (calibServo == CALIB_DONE) {
    servoOffsetA -= 25;
    servoOffsetB -= 25;
    servoOffsetC -= 25;
    EEPROM.put(EEPROM_ADDR_A, servoOffsetA);
    EEPROM.put(EEPROM_ADDR_B, servoOffsetB);
    EEPROM.put(EEPROM_ADDR_C, servoOffsetC);
    lastCalibServo = CALIB_DONE;
    mode = ON;
    return;
  }

  // Move active servo to calibration position
  if (calibServo == CALIB_A) moveServos(25, 70, 70);
  if (calibServo == CALIB_B) moveServos(70, 25, 70);
  if (calibServo == CALIB_C) moveServos(70, 70, 25);
}

// ============================================================================
// SERVO CONTROL
// ============================================================================

void moveServos(float a, float b, float c) {
  a = constrain(a, -10, 85);
  b = constrain(b, -10, 85);
  c = constrain(c, -10, 85);
  servoA.write(servoOffsetA - a);
  servoB.write(servoOffsetB - b);
  servoC.write(servoOffsetC - c);
}

// ============================================================================
// INVERSE KINEMATICS
// ============================================================================

void movePlatform(float rollDeg, float pitchDeg, float height) {
  float roll  = -rollDeg  * DEG2RAD;
  float pitch = -pitchDeg * DEG2RAD;

  float baseAngle[3] = {0, 120 * DEG2RAD, 240 * DEG2RAD};
  float platX[3], platY[3], platZ[3], angles[3];

  for (int i = 0; i < 3; i++) {
    float a  = baseAngle[i];
    float px = PLAT_R * cos(a);
    float py = PLAT_R * sin(a);
    float pz = height;
    float x1 =  px * cos(pitch) + pz * sin(pitch);
    float z1 = -px * sin(pitch) + pz * cos(pitch);
    float y1 =  py * cos(roll)  - z1 * sin(roll);
    float z2 =  py * sin(roll)  + z1 * cos(roll);
    platX[i] = x1; platY[i] = y1; platZ[i] = z2;
  }

  for (int i = 0; i < 3; i++) {
    float a   = baseAngle[i];
    float bx  = BASE_R * cos(a);
    float by  = BASE_R * sin(a);
    float dx  = platX[i] - bx;
    float dy  = platY[i] - by;
    float dz  = platZ[i];
    float dxl = dx * cos(a) + dy * sin(a);
    float dyl = dz;
    float d   = sqrt(dxl * dxl + dyl * dyl);
    float cosAngle = constrain((R1*R1 + d*d - R2*R2) / (2*R1*d), -1, 1);
    angles[i] = (atan2(dyl, dxl) - acos(cosAngle)) * RAD2DEG;
  }

  moveServos(angles[2], angles[0], angles[1]);
}

// ============================================================================
// LED CONTROL
// ============================================================================

void blinkLED(unsigned long interval) {
  static unsigned long lastToggle = 0;
  if (millis() - lastToggle >= interval) {
    digitalWrite(LED_PIN, !digitalRead(LED_PIN));
    lastToggle = millis();
  }
}

void blinkDoubleFlash() {
  static unsigned long lastChange = 0;
  static uint8_t step = 0;
  const unsigned long pattern[] = {100, 200, 100, 1000};
  const uint8_t      ledState[] = {HIGH, LOW, HIGH, LOW};
  unsigned long now = millis();
  if (now - lastChange >= pattern[step]) {
    lastChange = now;
    step = (step + 1) % 4;
    digitalWrite(LED_PIN, ledState[step]);
  }
}

// ============================================================================
// BUTTON INPUT
// ============================================================================

ButtonPress checkButton(bool calibrationMode) {
  static bool lastState = LOW;
  bool current = digitalRead(BUTTON_PIN);
  unsigned long now = millis();
  ButtonPress result = NO_PRESS;

  if (current == HIGH && lastState == LOW) buttonDownTime = now;

  if (current == LOW && lastState == HIGH) {
    unsigned long duration = now - buttonDownTime;
    if (duration >= LONG_PRESS_TIME) {
      result = LONG_PRESS;
      pressCount = 0;
    } else {
      pressCount++;
      lastPressTime = now;
    }
  }

  if (pressCount > 0 && (calibrationMode || now - lastPressTime > DOUBLE_PRESS_GAP)) {
    if      (pressCount == 1) result = SINGLE_PRESS;
    else if (pressCount == 2) result = DOUBLE_PRESS;
    else if (pressCount == 3) result = TRIPLE_PRESS;
    else if (pressCount == 4) result = QUAD_PRESS;
    pressCount = 0;
  }

  lastState = current;
  return result;
}

// ============================================================================
// IR SENSOR READING
// ============================================================================

void measureIR() {
  digitalWrite(IR_LED_PIN, LOW);
  for (int i = 0; i < 16; i++) {
    mux.channel(i);
    delayMicroseconds(600);
    ambientLight[i] = analogRead(IR_RECEIVER_PIN);
  }
  digitalWrite(IR_LED_PIN, HIGH);
  for (int i = 0; i < 16; i++) {
    mux.channel(i);
    delayMicroseconds(600);
    irLight[i] = analogRead(IR_RECEIVER_PIN);
  }
  for (int i = 0; i < 16; i++) irSignalRaw[i] = irLight[i] - ambientLight[i];
  for (int i = 0; i < 16; i++) irSignal[i] += IR_SMOOTH_ALPHA * (irSignalRaw[i] - irSignal[i]);
}

// ============================================================================
// BALL POSITION
// ============================================================================

bool ballOnPlate() {
  float minV = irSignal[0], maxV = irSignal[0];
  for (int i = 1; i < 16; i++) {
    minV = min(minV, irSignal[i]);
    maxV = max(maxV, irSignal[i]);
  }
  return (maxV - minV >= BALL_THRESHOLD);
}

void calculateWeightedCenter(const float arr[], float &x, float &y) {
  if (!ballOnPlate()) { x = y = 0; return; }

  float minV = arr[0], maxV = arr[0];
  for (int i = 1; i < 16; i++) {
    if (arr[i] < minV) minV = arr[i];
    if (arr[i] > maxV) maxV = arr[i];
  }
  float range = maxV - minV;
  if (range < 1e-6) { x = y = 0; return; }

  const int mirrorIdx[6] = {0, 0, 1, 2, 3, 3};
  float wx = 0, wy = 0, sumW = 0;

  for (int iy = -1; iy <= 4; iy++) {
    int my = mirrorIdx[iy + 1];
    for (int ix = -1; ix <= 4; ix++) {
      int mx = mirrorIdx[ix + 1];
      float v = (arr[my * 4 + mx] - minV) / range;
      if (v < 0) v = 0;
      float w = v * v * v;
      wx += ix * w; wy += iy * w; sumW += w;
    }
  }

  if (sumW < 1e-6) { x = y = 0; return; }
  x = wx / sumW - 1.5;
  y = wy / sumW - 1.5;
}

// ============================================================================
// PID CONTROLLER
// ============================================================================

void pidControl(float input, float target, float &lastErr, float &integ, float &out) {
  float error = target - input;
  integ += I_GAIN * error;
  float vel  = error - lastErr;
  float avel = vel >= 0 ? vel : -vel;
  float scale = avel / (avel + VEL_SCALE);
  out = P_GAIN * error + integ + D_GAIN * scale * vel;
  lastErr = error;
}

// ============================================================================
// SERIAL DEBUGGING
// ============================================================================

void handleSerialPID() {
  if (!Serial.available()) return;
  String cmd = Serial.readStringUntil('\n');
  cmd.trim();
  int pIdx = cmd.indexOf('P'), iIdx = cmd.indexOf('I'), dIdx = cmd.indexOf('D');
  if (pIdx != -1) P_GAIN = cmd.substring(pIdx+1, iIdx != -1 ? iIdx : (dIdx != -1 ? dIdx : cmd.length())).toFloat();
  if (iIdx != -1) I_GAIN = cmd.substring(iIdx+1, dIdx != -1 ? dIdx : cmd.length()).toFloat();
  if (dIdx != -1) D_GAIN = cmd.substring(dIdx+1).toFloat();
  Serial.print("Updated PID P="); Serial.print(P_GAIN);
  Serial.print(" I="); Serial.print(I_GAIN);
  Serial.print(" D="); Serial.println(D_GAIN);
}

void sendSerialData() {
  for (int i = 0; i < 16; i++) { Serial.print(irSignal[i]); Serial.print(','); }
  Serial.print(centerX); Serial.print(',');
  Serial.print(centerY); Serial.print(',');
  Serial.print(setpointX); Serial.print(',');
  Serial.println(setpointY);
}

void sendGraphData() {
  Serial.print("smoothRoll:");  Serial.print(smoothRoll);  Serial.print(",");
  Serial.print("smoothPitch:"); Serial.print(smoothPitch); Serial.print(",");
  Serial.print("PlateRoll:");   Serial.print(plateRoll);   Serial.print(",");
  Serial.print("PlatePitch:");  Serial.print(platePitch);  Serial.print(",");
  Serial.print("MeasX:");       Serial.print(centerX);     Serial.print(",");
  Serial.print("MeasY:");       Serial.println(centerY);
}

// ============================================================================
// PLATFORM TEST MODE
// ============================================================================

const float TEST_ROLL_AMPL  = 25.0;
const float TEST_PITCH_AMPL = 20.0;
const float TEST_SPEED      = 0.001;
const float TEST_HEIGHT     = PLATE_HEIGHT;

void runPlatformTest() {
  if (testStartTime == 0) testStartTime = millis();
  unsigned long t = millis() - testStartTime;
  float roll  = TEST_ROLL_AMPL  * sin(t * TEST_SPEED * 2 * PI);
  float pitch = TEST_PITCH_AMPL * sin(t * TEST_SPEED * 2 * PI + PI/2);
  movePlatform(roll, pitch, TEST_HEIGHT);
  static unsigned long lastPrint = 0;
  if (millis() - lastPrint > 1000) {
    Serial.print("Roll: "); Serial.print(roll);
    Serial.print(" , Pitch: "); Serial.println(pitch);
    lastPrint = millis();
  }
}
