Hemlock-white/Babot_revisioned_Mechatronics_TermProject/(commit log)

2026-10-10 Reconstruct initial through-hole Base and Plate layouts
2026-10-10 Replace Base multiplexer IC with through-hole module
2026-10-10 Refine two-layer through-hole Plate design
2026-10-13 Document original and THT electronics; archive Plate Gerber review
2026-10-13 Add illustrated offline circuit lessons for original and THT designs
2026-10-23 Integrate routed two-layer THT Plate PCB and fabrication package
    Plate layout by liu andy (https://github.com/andy100056en12-sys).
    Integrate the routed KiCad board, Gerber/drill ZIP, mask-corrected footprints,
    and fabrication notes. Archive the unrouted Plate and rejected maskless export.
    Validation: Plate PCB DRC 0 violations and 0 unconnected items; both mask
    plots have 143 openings and the plated drill plot has 162 hits.
2026-10-23 Add Base and Plate PCB bring-up sketches and test guides
    Document safe power sequencing, Base mux/ADC resistor-fixture checks,
    servo position tests, and standalone Uno-based Plate optical checks.
    Align Plate integrated-mode guidance with the fixed 10 kOhm resistor
    now installed at the Base RV1 pads.
    Validation: both sketches pass C++ syntax checks with Arduino API stubs;
    Plate sketch checked in standalone and Base-integrated modes.
2026-10-23 Record Base and Plate prototype bring-up
    Document the Base fixed 10 kOhm load repair, PT00 cal 0 isolation and
    stable result, the reported Q1/Q9 replacement on Plate, and the
    remaining position-servo test. Move the development log and software
    navigator into docs and update repository links.
    Validation: staged diff check passed; local Markdown links resolve.
2026-10-29 replace IR sensors with TSAL6200, currently unknown issue causes voltage drop at plate u1 to IRs. modified the mechanism design, detailed documentation will be added later.
2026-10-31 Add temporary ball-to-servo integration test mode
2026-10-31 Record integrated Plate and servo debugging progress
